angelofraietta/HappyBracketsPiHats/Image1.jpg

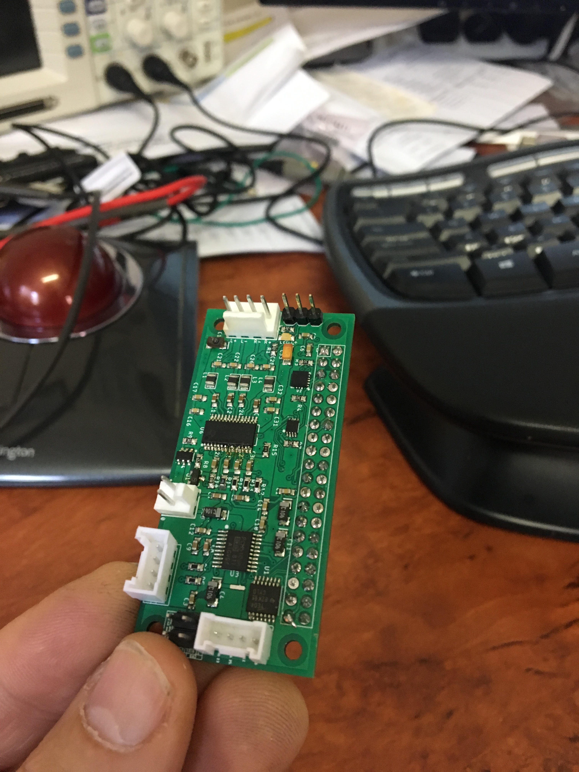
Image1.jpg
