angelofraietta/HappyBracketsPiHats/j8header-zero.png

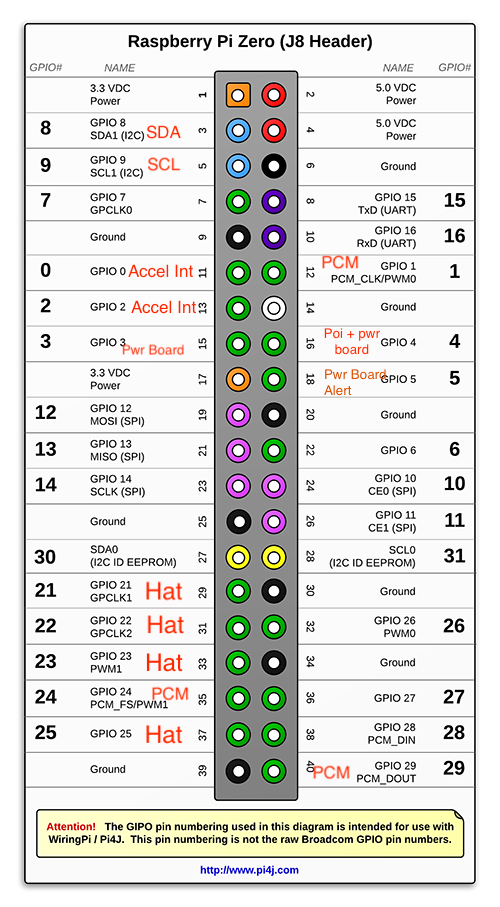
j8header-zero.png
