angelofraietta/HappyBracketsPiHats/PiZeroAudioI2S-01-Nov-18.xlsx

Part | list exported |  | from /Users/angelofraiet | ta/Documents/EAGLE/projects/HappyBracketsPiHats/ | PiZeroAudioI2S
Qty | Value | MPN | Device | Package | Parts | Description
9 | 0.1uF | CL10F104ZB8NNNC | C-EUC0603 | C0603 | C1, C2, C3, C6, C10, C12, C14, C17, C34 | CAPACITOR, European symbol
2 | 100uF | TLJA107M010R1400 | CAP-POLARISED1206-POLAR | EIA3216 | C18, C35 | Polarised capacitor 0603 Footprint
4 | 10K | RC0603FR-0710KL | R-US_R0603 | R0603 | R3, R4, R7, R14 | RESISTOR, American symbol
1 | 10R | RNCP0603FTD10R0 | R-US_R0603 | R0603 | R13 | RESISTOR, American symbol
4 | 10uF | F931C106MAA | CAP-POLARISED1206-POLAR | EIA3216 | C4, C11, C13, C15 | Polarised capacitor 0603 Footprint
6 | 1nF | 06035C102KAT2A | C-EUC0603 | C0603 | C16, C22, C23, C27, C29, C33 | CAPACITOR, European symbol
6 | 1uF | CL10B105MO8NNWC | C-EUC0603 | C0603 | C19, C21, C26, C28, C30, C32 | CAPACITOR, European symbol
2 | 2.2nF | 0603B222K500CT | C-EUC0603 | C0603 | C5, C7 | CAPACITOR, European symbol
2 | 2.2uF | C0603C225K8PACTU | C-EUC0603 | C0603 | C8, C9 | CAPACITOR, European symbol
2 | 220 | RC0603FR-07220RL | R-US_R0603 | R0603 | R1, R2 | RESISTOR, American symbol
4 | 220nF | EMK107B7224KA-T | C-EUC0603 | C0603 | C20, C24, C25, C31 | CAPACITOR, European symbol
1 | 2X1-LOCKING | 22-23-2021 | 2X1-LOCKING | 22-23-2021 | J3 | 2x1 Locking Header
1 | 2X2HEADER | PRPC002DAAN-RC | 2X2HEADER | 2X2 | J2 | 2x2 2.54mm header
3 | 33K | MCMR06X3302FTL | R-US_R0603 | R0603 | R10, R11, R12 | RESISTOR, American symbol
1 | 39K | RC0603FR-0739KL | R-US_R0603 | R0603 | R8 | RESISTOR, American symbol
2 | 76K8 | RMCF0603FT76K8 | R-US_R0603 | R0603 | R5, R6 | RESISTOR, American symbol
1 | 4X1-LOCKING | 22-23-2041 | 4X1-LOCKING | 22-23-2041 | J5
1 | 56K | CRCW060356K0FKEA. | R-US_R0603 | R0603 | R9 | RESISTOR, American symbol
1 | DMG2305UX | DMG2305UX-7 | DMG2305UX | SOT23 | Q1 | P-CHANNEL ENHANCEMENT MODE MOSFET
4 | FB | NFZ2MSM301SN10L | NFZ2MSML0806 | L0806 | L1, L2, L3, L4 | Ferrite Bead
2 | GROVE | 110990030 | GROVE | JST-PH4 | J1, J4
1 | Header 1x3 | PRPC003SAAN-RC | PINHD-1X3 | 1X03 | JP1 | PIN HEADER
1 | LSM6DS33 | LSM6DS33TR | LSM6DS33LGA-16-3X3 | LGA-16-3X3 | U2 | iNEMO inertial module:
1 | PCM5101A | PCM5101AQPWRQ1 | PCM5101A | TSSOP20-0.65-6.5X4.4MM | U3 | PCM510xA 2.1VRMS, 112/106/100dB AudioStereoDAC with PLL and 32-bit, 384 kHz PCM Interface
1 | RED | LH R974-LP-1 | LEDCHIP-LED0805 | CHIP-LED0805 | LED1 | LED
1 | RPI-Header | ADA2243 | 20x2 Header | Mounted on Bottom of board | CON1 | Mounted on Bottom Of Board
1 | TPA3144D2PWPR | TPA3144D2PWPR | TPA3144D2PWPR | HTSSOP28 | U5 | TPA3144D2PWPR
1 | TXB0104PWR | TXB0104PWR | TXB0104PWR | TSSOP14 | U1 | 4-Bit Bi-Directional Level Shifter
1 | TXS0102 | TXS0102DCURG4 | TXS0102 | VFSOP-8 | U4 | 2-Bit Bi-Directional Level Shifter (I2C, etc.)
