angelofraietta/HappyBracketsPiHats/Pi Zero I2S Bill of Materials.pdf

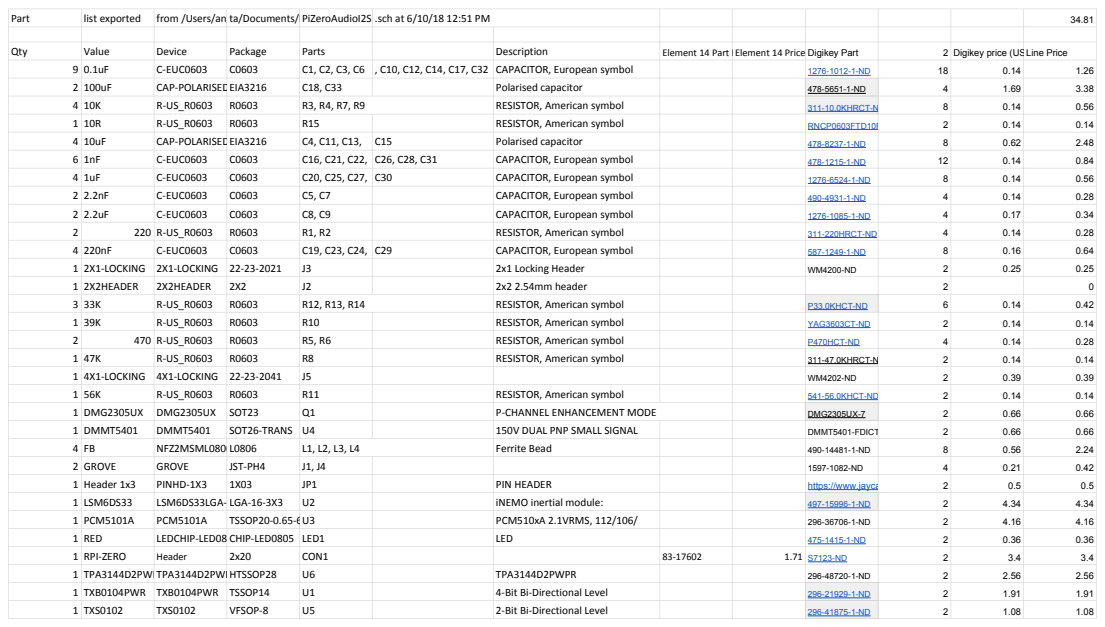
[picture p3: page 1]
