angelofraietta/HappyBracketsPiHats/PiZeroAudioI2S.pdf

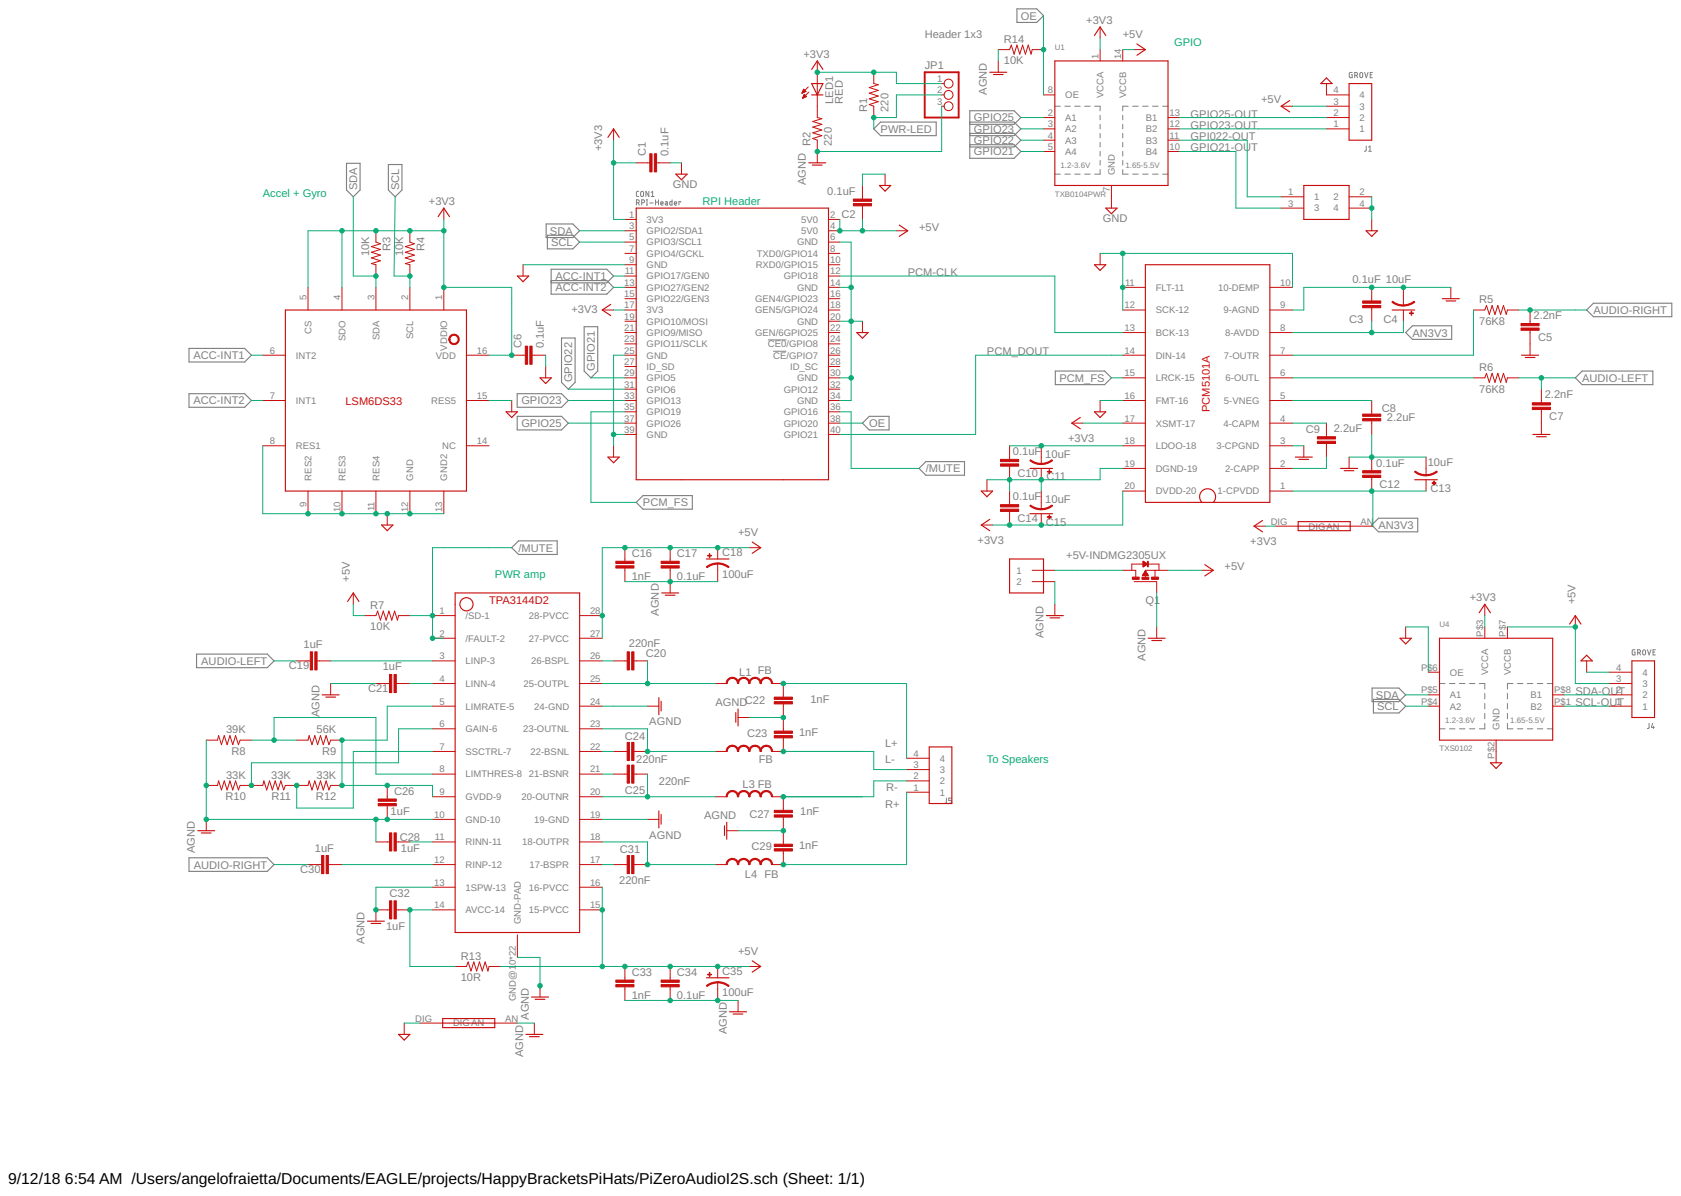
[picture p4: page 1]

9/12/18 6:54 AM /Users/angelofraietta/Documents/EAGLE/projects/HappyBracketsPiHats/PiZeroAudioI2S.sch (Sheet: 1/1)
