angelofraietta/HappyBracketsPiHats/PiZeroHifi.brd

## EAGLE design PiZeroHifi.brd (2020-08-05)

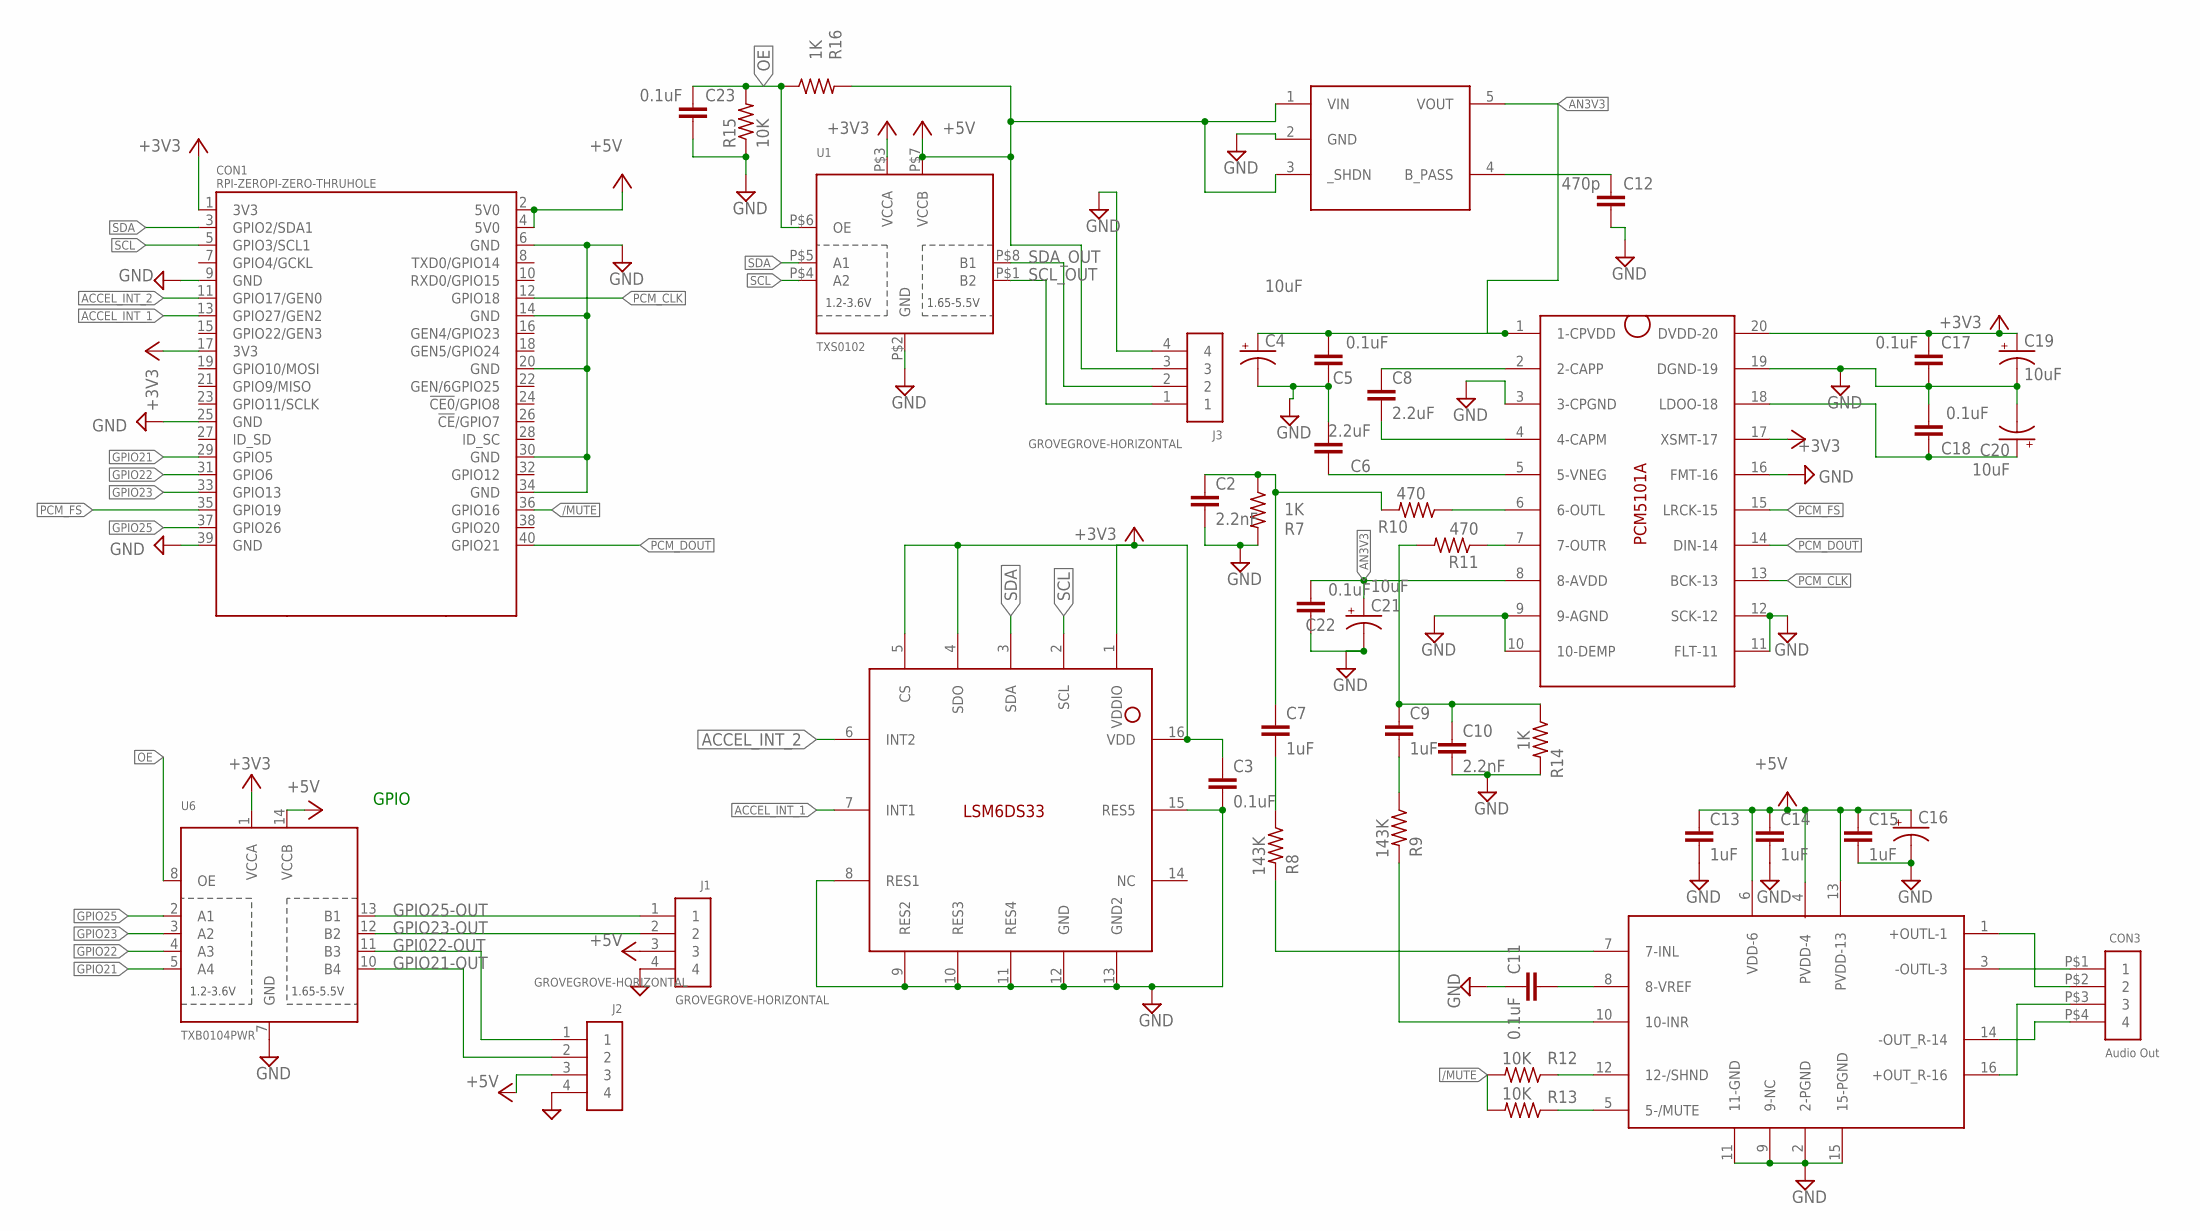
[picture p5: schematic PiZeroHifi.sch]

Parts:
C2, C10: 2.2nF; C0603; MPN CC0603KRX7R9BB222
C3, C5, C11, C17, C18, C22, C23: 0.1uF; C0603; MPN CC0603KRX7R7BB104
C4, C19, C20, C21: 10uF; EIA3216; MPN 08053D106KAT2A
C6, C8: 2.2uF; C0603
C7, C9, C13, C14, C15: 1uF; C0603; MPN 06033C104JAT2A
C12: 470p; C0603; MPN 06035C471KAT2A
C16: 1500uF; CAP8MMX3.5MMX20MM
CON1: RPI-ZEROPI-ZERO-THRUHOLE; RASPBERRYPI_ZERO_THRUHOLE
CON3: Audio Out; TERM-4P-SIDE-5.08MM
J1, J2, J3: GROVEGROVE-HORIZONTAL; JST-4-PTH
R7, R14, R16: 1K; R0603; MPN MCWR06X1001FTL
R8, R9: 143K; R0603; MPN ERJ3EKF1433V
R10, R11: 470; R0603; MPN CRCW0603470RFKEA
R12, R13, R15: 10K; R0603; MPN RC0603FR-0710KL
U1: TXS0102; VFSOP-8
U2: LSM6DS33; LGA-16-3X3
U3: TC1014-3.3V; GHI-IC_SOT23-5(MICROCHIP); MPN TC1014-3.3VCT713
U4: PCM5101A; TSSOP20-0.65-6.5X4.4MM
U5: PAM8403; SOP-16
U6: TXB0104PWR; TSSOP14; MPN TXB0104PWR .

Connections:
+3V3: C3.1, C17.2, C19.+, CON1.1 (3V3), CON1.17 (3V3), U1.P$3 (VCCA), U2.1 (VDDIO), U2.4 (SDO), U2.5 (CS), U2.16 (VDD), U4.17 (XSMT-17), U4.20 (DVDD-20), U6.1 (VCCA)
+5V: C13.1, C14.1, C15.1, C16.P$1 (+), CON1.2 (5V0), CON1.4 (5V0), J1.3, J2.3, J3.3, R16.2, U1.P$7 (VCCB), U3.1 (VIN), U3.3 (_SHDN), U5.4 (PVDD-4), U5.6 (VDD-6), U5.13 (PVDD-13), U6.14 (VCCB)
+L: CON3.P$2 (2), U5.1 (+OUTL-1)
+R: CON3.P$3 (3), U5.16 (+OUT_R-16)
-L: CON3.P$1 (1), U5.3 (-OUTL-3)
-R: CON3.P$4 (4), U5.14 (-OUT_R-14)
/MUTE: CON1.36 (GPIO16), R12.2, R13.2
ACCEL_INT_1: CON1.13 (GPIO27/GEN2), U2.7 (INT1)
ACCEL_INT_2: CON1.11 (GPIO17/GEN0), U2.6 (INT2)
AN3V3: C4.+, C5.2, C21.+, C22.2, U3.5 (VOUT), U4.1 (1-CPVDD), U4.8 (8-AVDD)
GND: C2.2, C3.2, C4.-, C5.1, C6.2, C10.2, C11.2, C12.1, C13.2, C14.2, C15.2, C16.P$2 (-), C17.1, C18.2, C19.-, C20.-, C21.-, C22.1, C23.1, CON1.6 (GND), CON1.9 (GND), CON1.14 (GND), CON1.20 (GND), CON1.25 (GND), CON1.30 (GND), CON1.34 (GND), CON1.39 (GND), J1.4, J2.4, J3.4, R7.2, R14.2, R15.1, U1.P$2 (GND), U2.8 (RES1), U2.9 (RES2), U2.10 (RES3), U2.11 (RES4), U2.12 (GND), U2.13 (GND2), U2.15 (RES5), U3.2 (GND), U4.3 (3-CPGND), U4.9 (9-AGND), U4.10 (10-DEMP), U4.11 (FLT-11), U4.12 (SCK-12), U4.16 (FMT-16), U4.19 (DGND-19), U5.2 (2-PGND), U5.9 (9-NC), U5.11 (11-GND), U5.15 (15-PGND), U6.7 (GND)
GPI022-OUT: J2.1, U6.11 (B3)
GPIO21: CON1.29 (GPIO5), U6.5 (A4)
GPIO21-OUT: J2.2, U6.10 (B4)
GPIO22: CON1.31 (GPIO6), U6.4 (A3)
GPIO23: CON1.33 (GPIO13), U6.3 (A2)
GPIO23-OUT: J1.2, U6.12 (B2)
GPIO25: CON1.37 (GPIO26), U6.2 (A1)
GPIO25-OUT: J1.1, U6.13 (B1)
unnamed: C8.1, U4.2 (2-CAPP)
unnamed: C8.2, U4.4 (4-CAPM)
unnamed: C6.1, U4.5 (5-VNEG)
unnamed: C18.1, C20.+, U4.18 (LDOO-18)
unnamed: R10.1, U4.6 (6-OUTL)
unnamed: R11.1, U4.7 (7-OUTR)
unnamed: C7.2, R8.1
unnamed: C9.1, C10.1, R11.2, R14.1
unnamed: C2.1, C7.1, R7.1, R10.2
unnamed: C9.2, R9.1
unnamed: R8.2, U5.7 (7-INL)
unnamed: R9.2, U5.10 (10-INR)
unnamed: C12.2, U3.4 (B_PASS)
unnamed: C11.1, U5.8 (8-VREF)
unnamed: R12.1, U5.12 (12-/SHND)
unnamed: R13.1, U5.5 (5-/MUTE)
OE: C23.2, R15.2, R16.1, U1.P$6 (OE), U6.8 (OE)
PCM_CLK: CON1.12 (GPIO18), U4.13 (BCK-13)
PCM_DOUT: CON1.40 (GPIO21), U4.14 (DIN-14)
PCM_FS: CON1.35 (GPIO19), U4.15 (LRCK-15)
SCL: CON1.5 (GPIO3/SCL1), U1.P$4 (A2), U2.2 (SCL)
SCL_OUT: J3.1, U1.P$1 (B2)
SDA: CON1.3 (GPIO2/SDA1), U1.P$5 (A1), U2.3 (SDA)
SDA_OUT: J3.2, U1.P$8 (B1)

Notes on the sheet:
GPIO

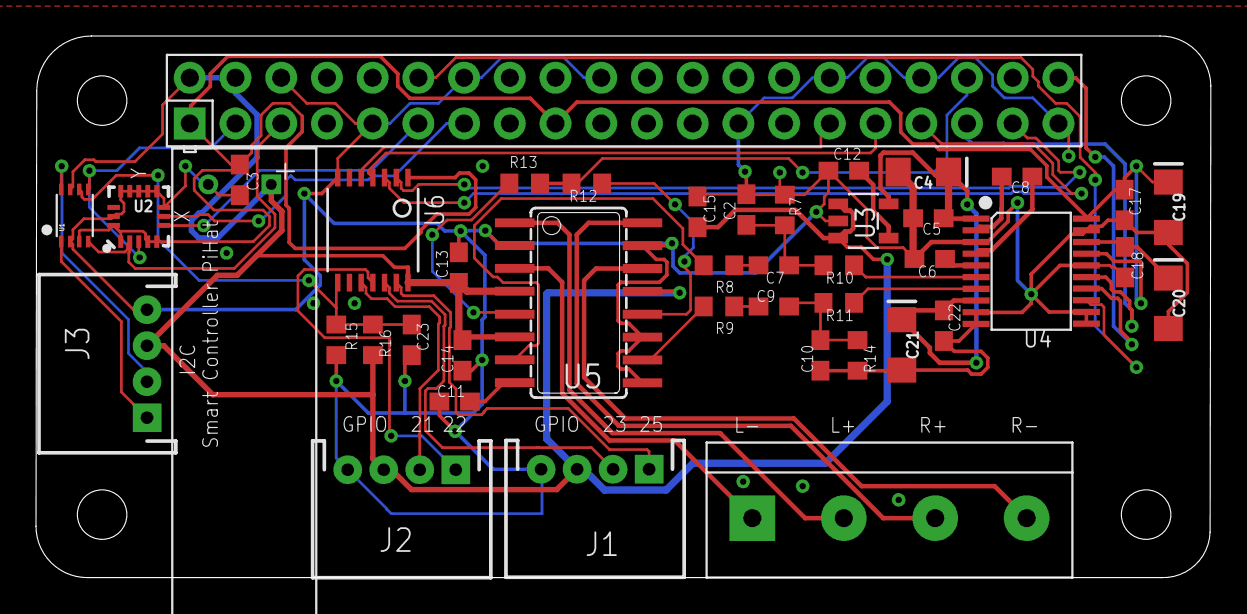
[picture p6: board PiZeroHifi.brd from above]

Board: 2 copper layers, 65.3 x 30.1 mm, 43 parts (0 on the bottom side), 43 nets.
