angelofraietta/HappyBracketsPiHats/PiZeroAudio.brd

## EAGLE design PiZeroAudio.brd (2020-05-15)

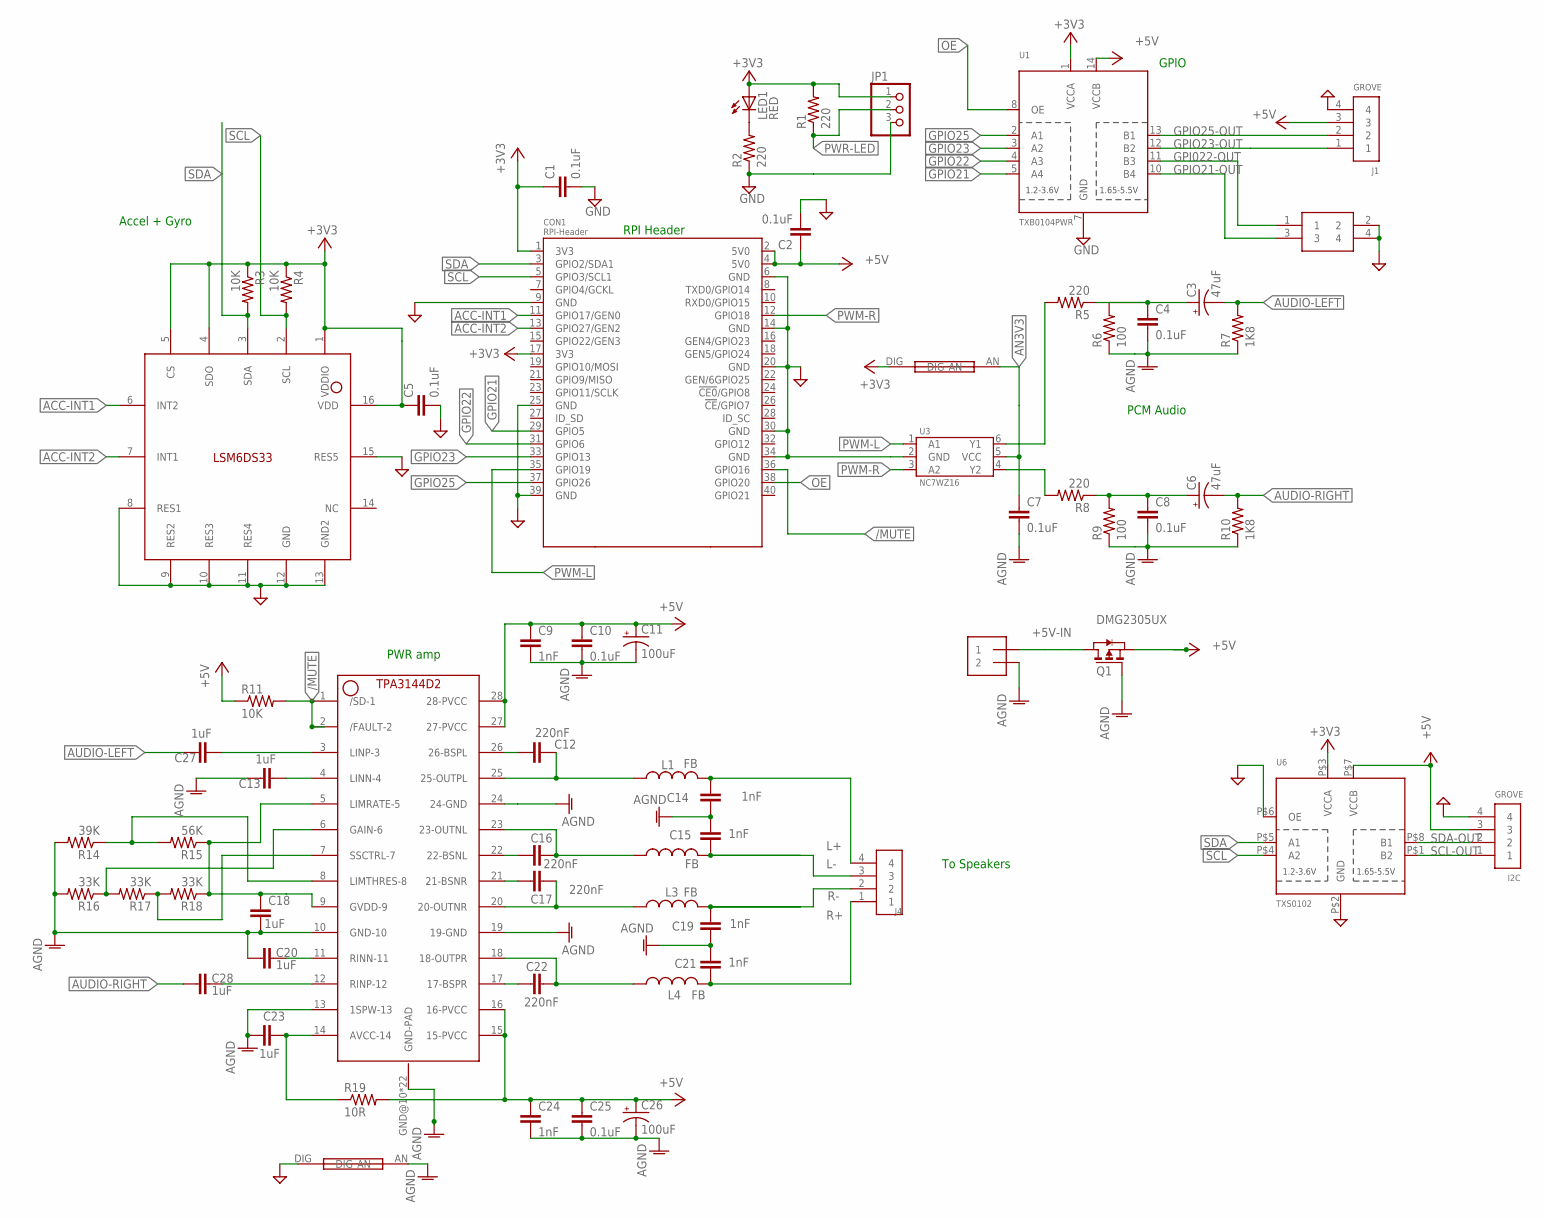
[picture p7: schematic PiZeroAudio.sch]

Parts:
C1, C2, C4, C5, C7, C8, C10, C25: 0.1uF; C0603
C3, C6: 47uF; EIA3216
C9, C14, C15, C19, C21, C24: 1nF; C0603
C11, C26: 100uF; EIA3216
C12, C16, C17, C22: 220nF; C0603
C13, C18, C20, C23, C27, C28: 1uF; C0603
CON1: RPI-Header; RASPBERRYPI_BASTELSTUBE_V13_RASPI_BOARD_B+_FULL
I2C: GROVE; JST-PH4
J1: GROVE; JST-PH4
J2: 2X2HEADER; 2X2
J3: 2X1-LOCKING; 22-23-2021
J4: 4X1-LOCKING; 22-23-2041
JP1: Header 1x3; 1X03
L1, L2, L3, L4: FB; L0806
LED1: RED; CHIP-LED0805
Q1: DMG2305UX; SOT23
R1, R2, R5, R8: 220; R0603
R3, R4, R11: 10K; R0603
R6, R9: 100; R0603
R7, R10: 1K8; R0603
R14: 39K; R0603
R15: 56K; R0603
R16, R17, R18: 33K; R0603
R19: 10R; R0603
SH1, SH2: SHORT
U1: TXB0104PWR; TSSOP14
U2: LSM6DS33; LGA-16-3X3
U3: NC7WZ16; SC-70-6
U5: TPA3144D2PWPR; HTSSOP28
U6: TXS0102; VFSOP-8

Connections:
+3V3: C1.1, C5.1, CON1.1 (3V3), CON1.17 (3V3), JP1.1, LED1.A, R1.2, R3.1, R4.1, SH1.DIG, U1.1 (VCCA), U2.1 (VDDIO), U2.4 (SDO), U2.5 (CS), U2.16 (VDD), U6.P$3 (VCCA)
+5V: C2.1, C9.1, C10.1, C11.+, C24.1, C25.1, C26.+, CON1.2 (5V0), CON1.4 (5V0), I2C.3, J1.3, Q1.S, R11.1, R19.2, U1.14 (VCCB), U5.15 (15-PVCC), U5.16 (16-PVCC), U5.27 (27-PVCC), U5.28 (28-PVCC), U6.P$7 (VCCB)
+5V-IN: J3.1, Q1.D
/MUTE: CON1.36 (GPIO16), R11.2, U5.1 (/SD-1), U5.2 (/FAULT-2)
ACC-INT1: CON1.11 (GPIO17/GEN0), U2.6 (INT2)
ACC-INT2: CON1.13 (GPIO27/GEN2), U2.7 (INT1)
AGND: C4.2, C7.2, C8.2, C9.2, C10.2, C11.-, C13.2, C14.2, C15.1, C18.2, C19.2, C20.2, C21.1, C23.2, C24.2, C25.2, C26.-, J3.2, Q1.G, R6.1, R7.1, R9.1, R10.1, R14.2, R16.2, SH2.AN, U5.10 (GND-10), U5.13 (1SPW-13), U5.19 (19-GND), U5.24 (24-GND), U5.GND@10 (GND-PAD), U5.GND@11 (GND-PAD), U5.GND@12 (GND-PAD), U5.GND@13 (GND-PAD), U5.GND@14 (GND-PAD), U5.GND@15 (GND-PAD), U5.GND@16 (GND-PAD), U5.GND@17 (GND-PAD), U5.GND@18 (GND-PAD), U5.GND@19 (GND-PAD), U5.GND@20 (GND-PAD), U5.GND@21 (GND-PAD), U5.GND@22 (GND-PAD), U5.GND@23 (GND-PAD), U5.GND@24 (GND-PAD), U5.GND@25 (GND-PAD), U5.GND@26 (GND-PAD), U5.GND@27 (GND-PAD), U5.GND@28 (GND-PAD), U5.GND@29 (GND-PAD), U5.GND@30 (GND-PAD), U5.GND@PAD (GND-PAD)
AN3V3: C7.1, SH1.AN, U3.5 (VCC)
AUDIO-LEFT: C3.-, C27.2, R7.2
AUDIO-RIGHT: C6.-, C28.2, R10.2
GND: C1.2, C2.2, C5.2, CON1.6 (GND), CON1.9 (GND), CON1.14 (GND), CON1.20 (GND), CON1.25 (GND), CON1.30 (GND), CON1.34 (GND), CON1.39 (GND), I2C.4, J1.4, J2.2, J2.4, JP1.3, R2.1, SH2.DIG, U1.7 (GND), U2.8 (RES1), U2.9 (RES2), U2.10 (RES3), U2.11 (RES4), U2.12 (GND), U2.13 (GND2), U2.15 (RES5), U3.2 (GND), U6.P$2 (GND), U6.P$6 (OE)
GPI022-OUT: J2.1, U1.11 (B3)
GPIO21: CON1.29 (GPIO5), U1.5 (A4)
GPIO21-OUT: J2.3, U1.10 (B4)
GPIO22: CON1.31 (GPIO6), U1.4 (A3)
GPIO23: CON1.33 (GPIO13), U1.3 (A2)
GPIO23-OUT: J1.1, U1.12 (B2)
GPIO25: CON1.37 (GPIO26), U1.2 (A1)
GPIO25-OUT: J1.2, U1.13 (B1)
L+: C14.1, J4.4, L1.2
L-: C15.2, J4.3, L2.2
unnamed: C3.+, C4.1, R5.1, R6.2
unnamed: R5.2, U3.6 (Y1)
unnamed: R8.2, U3.4 (Y2)
unnamed: C6.+, C8.1, R8.1, R9.2
unnamed: C27.1, U5.3 (LINP-3)
unnamed: LED1.C, R2.2
unnamed: C13.1, U5.4 (LINN-4)
unnamed: C20.1, U5.11 (RINN-11)
unnamed: C23.1, R19.1, U5.14 (AVCC-14)
unnamed: C22.2, U5.17 (17-BSPR)
unnamed: C28.1, U5.12 (RINP-12)
unnamed: C17.2, U5.21 (21-BSNR)
unnamed: C16.2, U5.22 (22-BSNL)
unnamed: C12.2, U5.26 (26-BSPL)
unnamed: C12.1, L1.1, U5.25 (25-OUTPL)
unnamed: C16.1, L2.1, U5.23 (23-OUTNL)
unnamed: C17.1, L3.1, U5.20 (20-OUTNR)
unnamed: C22.1, L4.1, U5.18 (18-OUTPR)
unnamed: R16.1, R17.2, U5.6 (GAIN-6)
unnamed: R17.1, R18.2, U5.7 (SSCTRL-7)
unnamed: R14.1, R15.2, U5.8 (LIMTHRES-8)
unnamed: C18.1, R15.1, R18.1, U5.5 (LIMRATE-5), U5.9 (GVDD-9)
OE: CON1.38 (GPIO20), U1.8 (OE)
PWM-L: CON1.35 (GPIO19), U3.1 (A1)
PWM-R: CON1.12 (GPIO18), U3.3 (A2)
PWR-LED: JP1.2, R1.1
R+: C21.2, J4.1, L4.2
R-: C19.1, J4.2, L3.2
SCL: CON1.5 (GPIO3/SCL1), R4.2, U2.2 (SCL), U6.P$4 (A2)
SCL-OUT: I2C.1, U6.P$1 (B2)
SDA: CON1.3 (GPIO2/SDA1), R3.2, U2.3 (SDA), U6.P$5 (A1)
SDA-OUT: I2C.2, U6.P$8 (B1)

Notes on the sheet:
Accel + Gyro
GPIO
PCM Audio
PWR amp
RPI Header
To Speakers

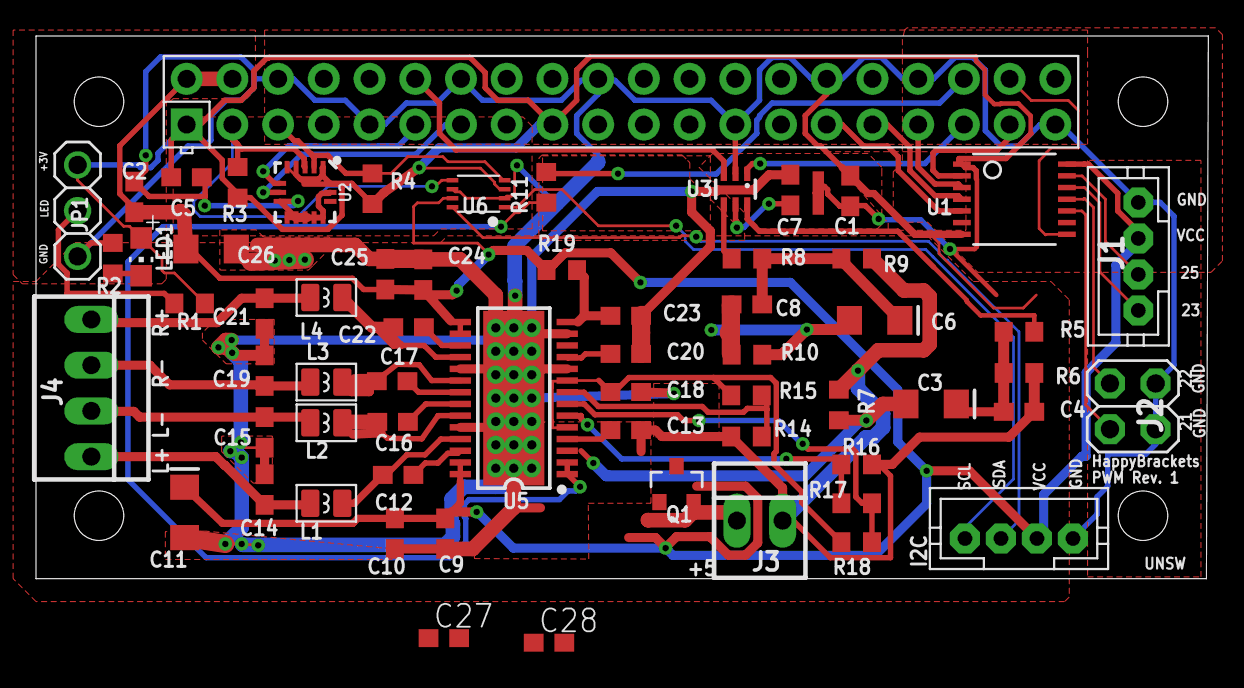
[picture p8: board PiZeroAudio.brd from above]

Board: 2 copper layers, 65.1 x 30.2 mm, 65 parts (0 on the bottom side), 53 nets.
