angelofraietta/HappyBracketsPiHats/PiZeroAudioI2SPam8403.brd

## EAGLE design PiZeroAudioI2SPam8403.brd (2020-05-15)

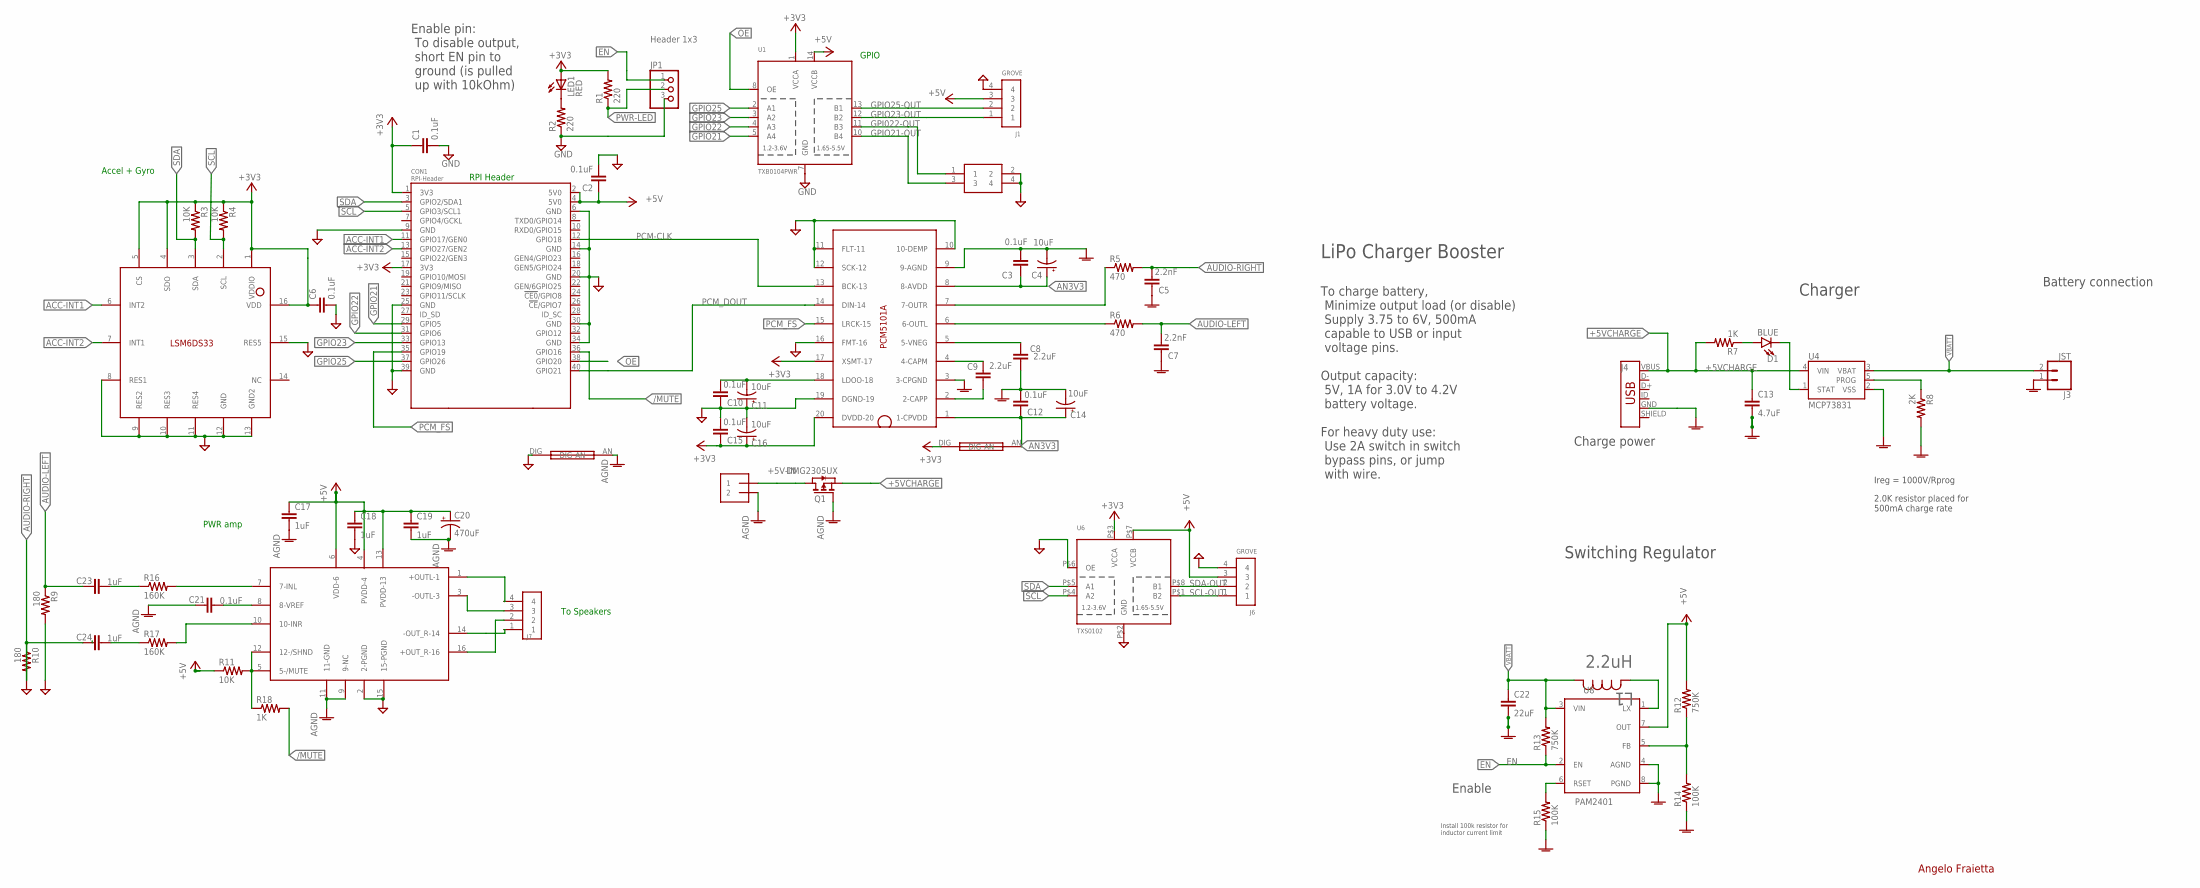
[picture p9: schematic PiZeroAudioI2SPam8403.sch]

Parts:
C1, C2, C3, C6, C10, C12, C15, C21: 0.1uF; C0603; MPN MC0603F104Z500CT
C4, C11, C14, C16: 10uF; EIA3216; MPN F931C106MAA
C5, C7: 2.2nF; C0603
C8, C9: 2.2uF; C0603; MPN TMK107ABJ225KA-T
C13: 4.7uF; C0603
C17, C18, C19: 1uF; C0603
C20: 470uF; EIA7343; MPN 293D477X9010E2TE3
C22: 22uF; C0603; MPN GRM188R61A226ME15D
C23, C24: 1uF; C0603; MPN MC0603F104Z500CT
CON1: RPI-Header; RASPBERRYPI_BASTELSTUBE_V13_RASPI_BOARD_B+_FULL
D1: BLUE; LED-0603
J1, J6: GROVE; JST-PH4
J2: 2X2HEADER; 2X2
J3: JST; JST-2-SMD; MPN S2B-PH-SM4-TB(LF)(SN)
J4: AMP FCI 10103594-0001LF; USB-MICROB-PTH; MPN 10103594-0001LF
J5: 2X1-LOCKING; 22-23-2021
J7: 4X1-LOCKING; 22-23-2041
JP1: Header 1x3; 1X03
L1: 2.2uH; IND_IFSC_1515AH; MPN IFSC1515AHER2R2M01
LED1: RED; CHIP-LED0805
Q1: DMG2305UX; SOT23; MPN DMG2305UX-7
R1, R2: 220; R0603; MPN RC0603FR-07220RL
R3, R4, R11: 10K; R0603; MPN RC0603FR-0710KL
R5, R6: 470; R0603; MPN ERJ3EKF4700V
R7: 1K; R0603; MPN CRCW06031K00FKEA
R8: 2K; R0603
R9, R10: 180; R0603; MPN ERJ3EKF4700V
R12, R13: 750K; R0603; MPN CRCW0603750KFKEA
R14, R15: 100K; R0603; MPN ERJ-3EKF1003V
R16, R17: 160K; R0603; MPN ERJ3EKF4700V
R18: 1K; R0603; MPN RC0603FR-0710KL
SH1, SH2: SHORT
U1: TXB0104PWR; TSSOP14; MPN TXB0104PWR
U2: LSM6DS33; LGA-16-3X3; MPN LSM6DS33TR
U3: PCM5101A; TSSOP20-0.65-6.5X4.4MM; MPN PCM5101AQPWRQ1
U4: MCP73831; SOT23-5; MPN MCP73831T-2ACI/OT
U6: TXS0102; VFSOP-8
U7: PAM8403; SOP-16
U8: PAM2401; MSOP8

Connections:
+3V3: C1.1, C6.1, C15.2, C16.+, CON1.1 (3V3), CON1.17 (3V3), LED1.A, R1.2, R3.1, R4.1, SH1.DIG, U1.1 (VCCA), U2.1 (VDDIO), U2.4 (SDO), U2.5 (CS), U2.16 (VDD), U3.17 (XSMT-17), U3.20 (DVDD-20), U6.P$3 (VCCA)
+5V: C2.1, C17.1, C18.1, C19.1, C20.+, CON1.2 (5V0), CON1.4 (5V0), J1.3, J6.3, R11.1, R12.2, U1.14 (VCCB), U6.P$7 (VCCB), U7.4 (PVDD-4), U7.6 (VDD-6), U7.13 (PVDD-13), U8.7 (OUT)
+5V-IN: J5.1, Q1.D
+5VCHARGE: C13.1, J4.VBUS, Q1.S, R7.2, U4.4 (VIN)
/MUTE: CON1.36 (GPIO16), R11.2, R18.1, R18.2, U7.5 (5-/MUTE), U7.12 (12-/SHND)
ACC-INT1: CON1.11 (GPIO17/GEN0), U2.6 (INT2)
ACC-INT2: CON1.13 (GPIO27/GEN2), U2.7 (INT1)
AGND: C3.1, C4.-, C5.2, C7.2, C8.2, C12.1, C13.2, C14.-, C17.2, C19.2, C20.-, C21.2, C22.2, J3.1 (2), J4.GND, J5.2, Q1.G, R8.2, R14.1, R15.1, SH2.AN, U3.3 (3-CPGND), U3.9 (9-AGND), U4.2 (VSS), U7.9 (9-NC), U7.11 (11-GND), U8.4 (AGND), U8.8 (PGND)
AN3V3: C3.2, C4.+, C12.2, C14.+, SH1.AN, U3.1 (1-CPVDD), U3.8 (8-AVDD)
AUDIO-LEFT: C7.1, C23.2, R6.2, R9.1
AUDIO-RIGHT: C5.1, R5.2, R10.1
EN: JP1.1, R13.1, U8.2 (EN)
GND: C1.2, C2.2, C6.2, C10.2, C11.+, C15.1, C16.-, C18.2, C24.2, CON1.6 (GND), CON1.9 (GND), CON1.14 (GND), CON1.20 (GND), CON1.25 (GND), CON1.30 (GND), CON1.34 (GND), CON1.39 (GND), J1.4, J2.2, J2.4, J6.4, JP1.3, R2.1, R9.2, R10.2, SH2.DIG, U1.7 (GND), U2.8 (RES1), U2.9 (RES2), U2.10 (RES3), U2.11 (RES4), U2.12 (GND), U2.13 (GND2), U2.15 (RES5), U3.10 (10-DEMP), U3.11 (FLT-11), U3.12 (SCK-12), U3.16 (FMT-16), U3.19 (DGND-19), U6.P$2 (GND), U6.P$6 (OE), U7.2 (2-PGND), U7.15 (15-PGND)
GPI022-OUT: J2.1, U1.11 (B3)
GPIO21: CON1.29 (GPIO5), U1.5 (A4)
GPIO21-OUT: J2.3, U1.10 (B4)
GPIO22: CON1.31 (GPIO6), U1.4 (A3)
GPIO23: CON1.33 (GPIO13), U1.3 (A2)
GPIO23-OUT: J1.1, U1.12 (B2)
GPIO25: CON1.37 (GPIO26), U1.2 (A1)
GPIO25-OUT: J1.2, U1.13 (B1)
L+: J7.4, U7.1 (+OUTL-1)
L-: J7.3, U7.3 (-OUTL-3)
unnamed: R5.1, U3.7 (7-OUTR)
unnamed: C8.1, U3.5 (5-VNEG)
unnamed: C9.1, U3.4 (4-CAPM)
unnamed: C9.2, U3.2 (2-CAPP)
unnamed: C24.1, R17.1
unnamed: LED1.C, R2.2
unnamed: C21.1, U7.8 (8-VREF)
unnamed: R16.2, U7.7 (7-INL)
unnamed: R17.2, U7.10 (10-INR)
unnamed: R6.1, U3.6 (6-OUTL)
unnamed: C10.1, C11.-, U3.18 (LDOO-18)
unnamed: C23.1, R16.1
unnamed: R8.1, U4.5 (PROG)
unnamed: D1.C, U4.1 (STAT)
unnamed: R12.1, R14.2, U8.5 (FB)
unnamed: L1.2, U8.1 (LX)
unnamed: R15.2, U8.6 (RSET)
unnamed: D1.A, R7.1
OE: CON1.38 (GPIO20), U1.8 (OE)
PCM-CLK: CON1.12 (GPIO18), U3.13 (BCK-13)
PCM_DOUT: CON1.40 (GPIO21), U3.14 (DIN-14)
PCM_FS: CON1.35 (GPIO19), U3.15 (LRCK-15)
PWR-LED: JP1.2, R1.1
R+: J7.2, U7.16 (+OUT_R-16)
R-: J7.1, U7.14 (-OUT_R-14)
SCL: CON1.5 (GPIO3/SCL1), R4.2, U2.2 (SCL), U6.P$4 (A2)
SCL-OUT: J6.1, U6.P$1 (B2)
SDA: CON1.3 (GPIO2/SDA1), R3.2, U2.3 (SDA), U6.P$5 (A1)
SDA-OUT: J6.2, U6.P$8 (B1)
VBATT: C22.1, J3.2 (1), L1.1, R13.2, U4.3 (VBAT), U8.3 (VIN)

Notes on the sheet:
Accel + Gyro
GPIO
PWR amp
RPI Header
To Speakers
Charger
Switching Regulator
Angelo Fraietta
2.0K resistor placed for 500mA charge rate
Ireg = 1000V/Rprog
To charge battery, Minimize output load (or disable) Supply 3.75 to 6V, 500mA capable to USB or input voltage pins.
Install 100k resistor for inductor current limit
LiPo Charger Booster
Output capacity: 5V, 1A for 3.0V to 4.2V battery voltage.
Enable pin: To disable output, short EN pin to ground (is pulled up with 10kOhm)
Enable
Charge power
Battery connection
For heavy duty use: Use 2A switch in switch bypass pins, or jump with wire.

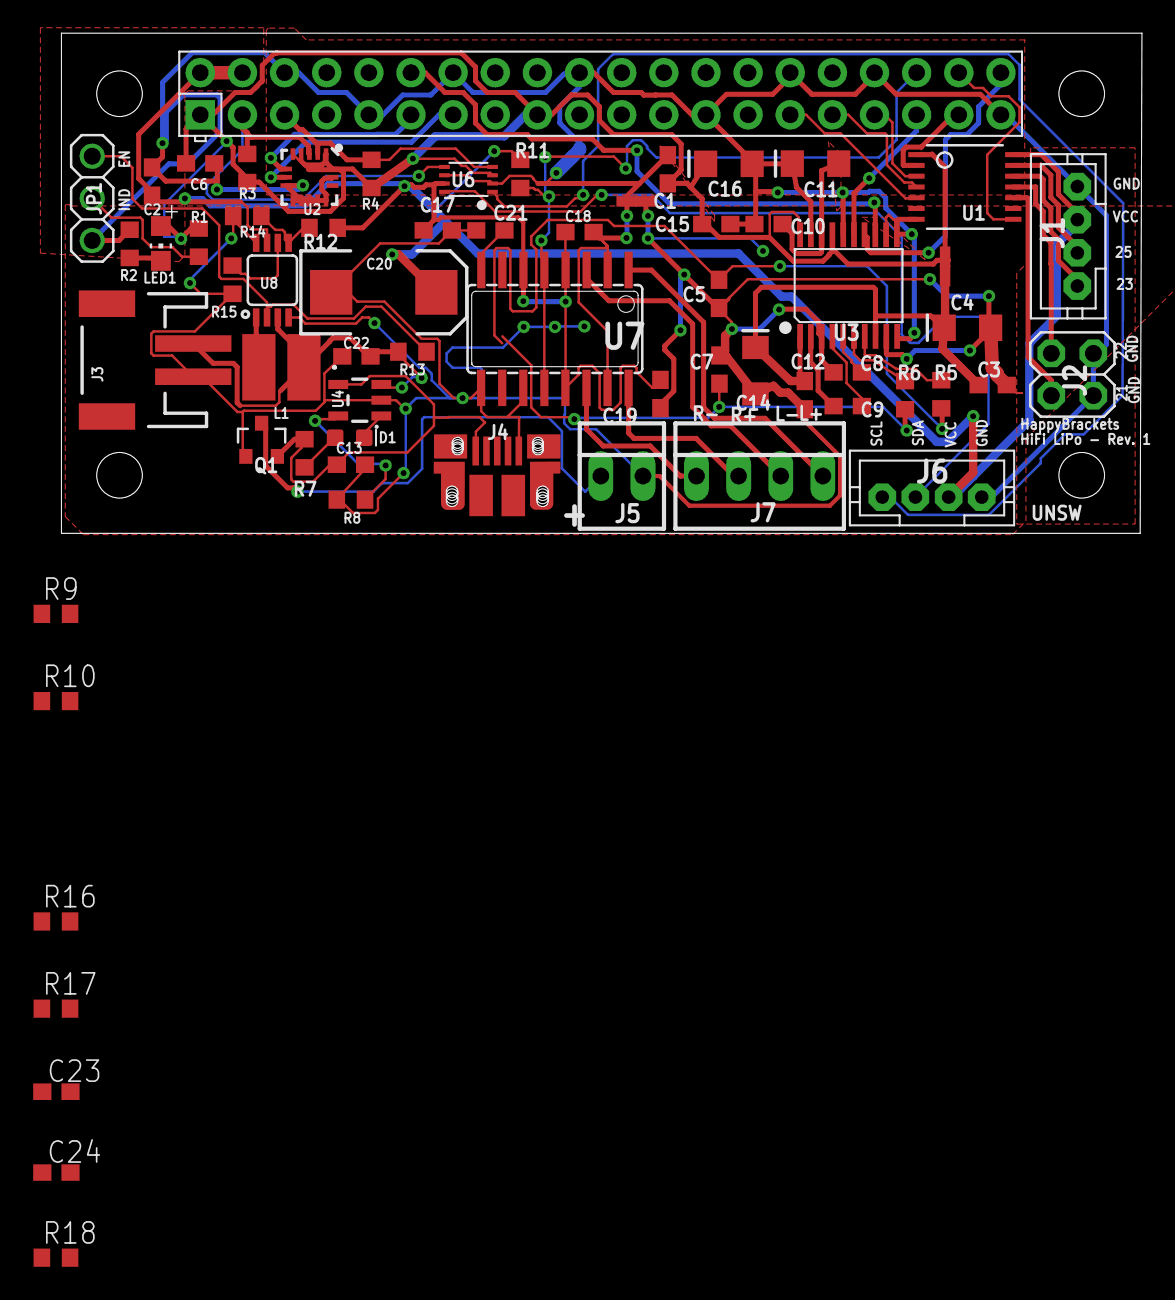
[picture p10: board PiZeroAudioI2SPam8403.brd from above]

Board: 2 copper layers, 65.1 x 30.2 mm, 64 parts (0 on the bottom side), 53 nets.
