angelofraietta/HappyBracketsPiHats/PiZeroAudioI2S.brd

## EAGLE design PiZeroAudioI2S.brd (2020-05-15)

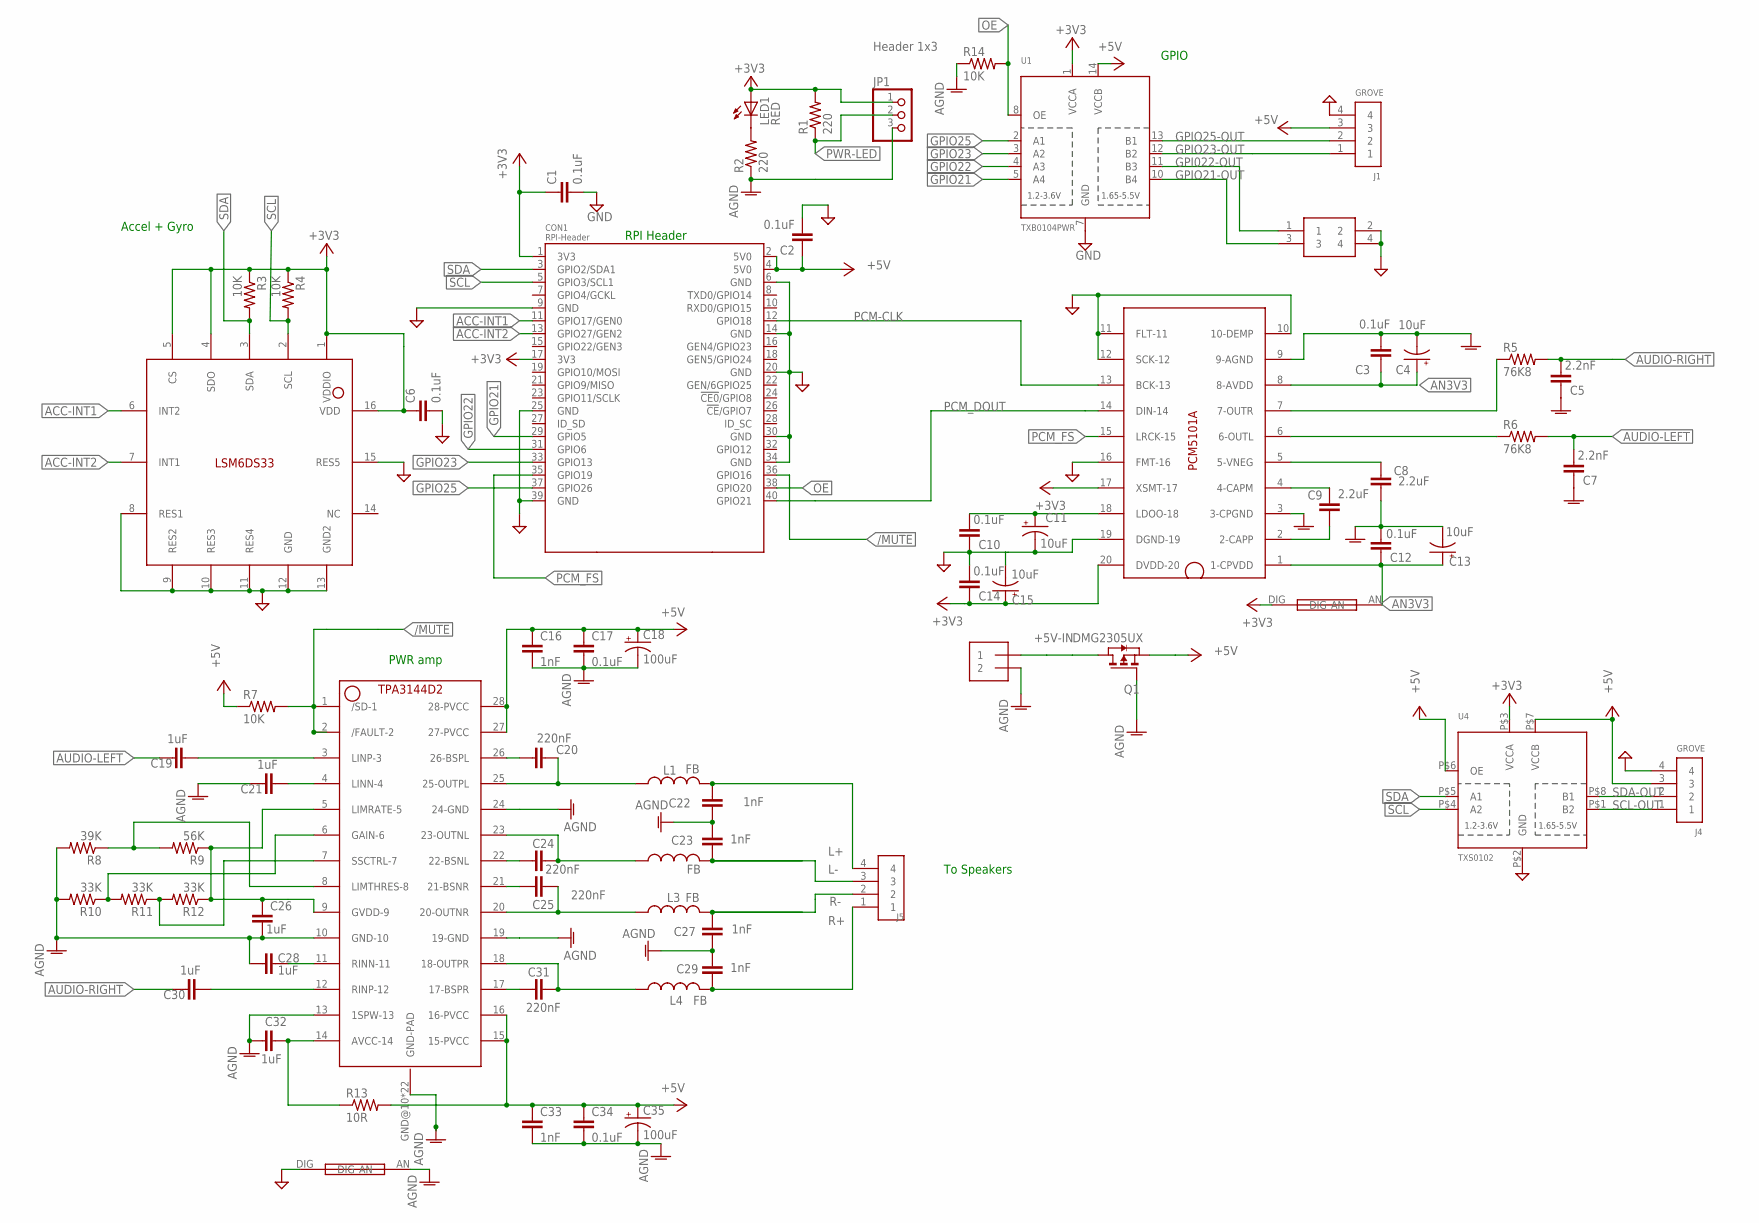
[picture p11: schematic PiZeroAudioI2S.sch]

Parts:
C1, C2, C3, C6, C10, C12, C14, C17, C34: 0.1uF; C0603
C4, C11, C13, C15: 10uF; EIA3216; MPN F931C106MAA
C5, C7: 2.2nF; C0603; MPN 0603B222K500CT
C8, C9: 2.2uF; C0603; MPN C0603C225K8PACTU
C16, C22, C23, C27, C29, C33: 1nF; C0603; MPN 06035C102KAT2A
C18, C35: 100uF; EIA3216; MPN TLJA107M010R1400
C19, C21, C26, C28, C30, C32: 1uF; C0603
C20, C24, C25, C31: 220nF; C0603; MPN EMK107B7224KA-T
CON1: RPI-Header; RASPBERRYPI_BASTELSTUBE_V13_RASPI_BOARD_B+_FULL
J1, J4: GROVE; JST-PH4
J2: 2X2HEADER; 2X2
J3: 2X1-LOCKING; 22-23-2021; MPN 22-23-2021
J5: 4X1-LOCKING; 22-23-2041; MPN 22-23-2041
JP1: Header 1x3; 1X03
L1, L2, L3, L4: FB; L0806
LED1: RED; CHIP-LED0805
Q1: DMG2305UX; SOT23; MPN DMG2305UX-7
R1, R2: 220; R0603
R3, R4, R7, R14: 10K; R0603; MPN RC0603FR-0710KL
R5, R6: 76K8; R0603; MPN RMCF0603FT76K8
R8: 39K; R0603; MPN RC0603FR-0739KL
R9: 56K; R0603; MPN CRCW060356K0FKEA.
R10, R11, R12: 33K; R0603; MPN MCMR06X3302FTL
R13: 10R; R0603
SH1, SH2: SHORT
U1: TXB0104PWR; TSSOP14; MPN TXB0104PWR
U2: LSM6DS33; LGA-16-3X3; MPN LSM6DS33TR
U3: PCM5101A; TSSOP20-0.65-6.5X4.4MM; MPN PCM5101AQPWRQ1
U4: TXS0102; VFSOP-8
U5: TPA3144D2PWPR; HTSSOP28

Connections:
+5V-IN: J3.1, Q1.D
/MUTE: CON1.36 (GPIO16), R7.2, U5.1 (/SD-1), U5.2 (/FAULT-2)
ACC-INT1: CON1.11 (GPIO17/GEN0), U2.6 (INT2)
ACC-INT2: CON1.13 (GPIO27/GEN2), U2.7 (INT1)
AGND: C3.1, C4.-, C5.2, C7.2, C8.2, C12.1, C13.-, C16.2, C17.2, C18.-, C21.2, C22.2, C23.1, C26.2, C27.2, C28.2, C29.1, C32.2, C33.2, C34.2, C35.-, J3.2, JP1.3, Q1.G, R2.1, R8.2, R10.2, R14.1, SH2.AN, U3.3 (3-CPGND), U3.9 (9-AGND), U5.10 (GND-10), U5.13 (1SPW-13), U5.19 (19-GND), U5.24 (24-GND), U5.GND@10 (GND-PAD), U5.GND@11 (GND-PAD), U5.GND@12 (GND-PAD), U5.GND@13 (GND-PAD), U5.GND@14 (GND-PAD), U5.GND@15 (GND-PAD), U5.GND@16 (GND-PAD), U5.GND@17 (GND-PAD), U5.GND@18 (GND-PAD), U5.GND@19 (GND-PAD), U5.GND@20 (GND-PAD), U5.GND@21 (GND-PAD), U5.GND@22 (GND-PAD), U5.GND@23 (GND-PAD), U5.GND@24 (GND-PAD), U5.GND@25 (GND-PAD), U5.GND@26 (GND-PAD), U5.GND@27 (GND-PAD), U5.GND@28 (GND-PAD), U5.GND@29 (GND-PAD), U5.GND@30 (GND-PAD), U5.GND@PAD (GND-PAD)
AN3V3: C3.2, C4.+, C12.2, C13.+, SH1.AN, U3.1 (1-CPVDD), U3.8 (8-AVDD)
AUDIO-LEFT: C7.1, C19.2, R6.2
AUDIO-RIGHT: C5.1, C30.2, R5.2
GND: C1.2, C2.2, C6.2, C10.2, C11.-, C14.1, C15.-, CON1.6 (GND), CON1.9 (GND), CON1.14 (GND), CON1.20 (GND), CON1.25 (GND), CON1.30 (GND), CON1.34 (GND), CON1.39 (GND), J1.4, J2.2, J2.4, J4.4, SH2.DIG, U1.7 (GND), U2.8 (RES1), U2.9 (RES2), U2.10 (RES3), U2.11 (RES4), U2.12 (GND), U2.13 (GND2), U2.15 (RES5), U3.10 (10-DEMP), U3.11 (FLT-11), U3.12 (SCK-12), U3.16 (FMT-16), U3.19 (DGND-19), U4.P$2 (GND)
GPI022-OUT: J2.1, U1.11 (B3)
GPIO21: CON1.29 (GPIO5), U1.5 (A4)
GPIO21-OUT: J2.3, U1.10 (B4)
GPIO22: CON1.31 (GPIO6), U1.4 (A3)
GPIO23: CON1.33 (GPIO13), U1.3 (A2)
GPIO23-OUT: J1.1, U1.12 (B2)
GPIO25: CON1.37 (GPIO26), U1.2 (A1)
GPIO25-OUT: J1.2, U1.13 (B1)
L+: C22.1, J5.4, L1.2
L-: C23.2, J5.3, L2.2
unnamed: R5.1, U3.7 (7-OUTR)
unnamed: C8.1, U3.5 (5-VNEG)
unnamed: C9.1, U3.4 (4-CAPM)
unnamed: C9.2, U3.2 (2-CAPP)
unnamed: LED1.C, R2.2
unnamed: C21.1, U5.4 (LINN-4)
unnamed: C28.1, U5.11 (RINN-11)
unnamed: C32.1, R13.1, U5.14 (AVCC-14)
unnamed: C31.2, U5.17 (17-BSPR)
unnamed: R6.1, U3.6 (6-OUTL)
unnamed: C10.1, C11.+, U3.18 (LDOO-18)
unnamed: C25.2, U5.21 (21-BSNR)
unnamed: C19.1, U5.3 (LINP-3)
unnamed: C30.1, U5.12 (RINP-12)
unnamed: C24.2, U5.22 (22-BSNL)
unnamed: C20.2, U5.26 (26-BSPL)
unnamed: C20.1, L1.1, U5.25 (25-OUTPL)
unnamed: C24.1, L2.1, U5.23 (23-OUTNL)
unnamed: C25.1, L3.1, U5.20 (20-OUTNR)
unnamed: C31.1, L4.1, U5.18 (18-OUTPR)
unnamed: R10.1, R11.2, U5.6 (GAIN-6)
unnamed: R11.1, R12.2, U5.7 (SSCTRL-7)
unnamed: R8.1, R9.2, U5.8 (LIMTHRES-8)
unnamed: C26.1, R9.1, R12.1, U5.5 (LIMRATE-5), U5.9 (GVDD-9)
OE: CON1.38 (GPIO20), R14.2, U1.8 (OE)
PCM-CLK: CON1.12 (GPIO18), U3.13 (BCK-13)
PCM_DOUT: CON1.40 (GPIO21), U3.14 (DIN-14)
PCM_FS: CON1.35 (GPIO19), U3.15 (LRCK-15)
PWR-LED: JP1.2, R1.1
R+: C29.2, J5.1, L4.2
R-: C27.1, J5.2, L3.2
SCL: CON1.5 (GPIO3/SCL1), R4.2, U2.2 (SCL), U4.P$4 (A2)
SCL-OUT: J4.1, U4.P$1 (B2)
SDA: CON1.3 (GPIO2/SDA1), R3.2, U2.3 (SDA), U4.P$5 (A1)
SDA-OUT: J4.2, U4.P$8 (B1)

Notes on the sheet:
Accel + Gyro
GPIO
PWR amp
RPI Header
To Speakers

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
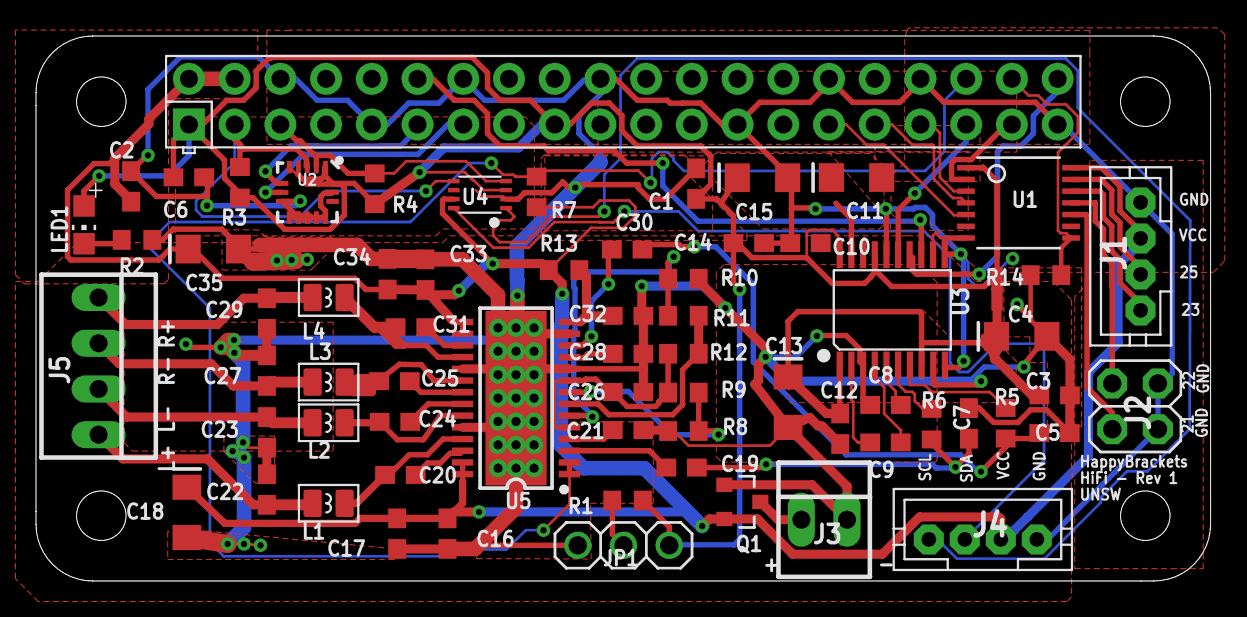
[picture p12: board PiZeroAudioI2S.brd from above]

Board: 2 copper layers, 65.3 x 30.3 mm, 69 parts (0 on the bottom side), 56 nets.
