angelofraietta/HappyBracketsPiHats/Pi-Breakout.brd

## EAGLE design Pi-Breakout.brd (2020-05-15)

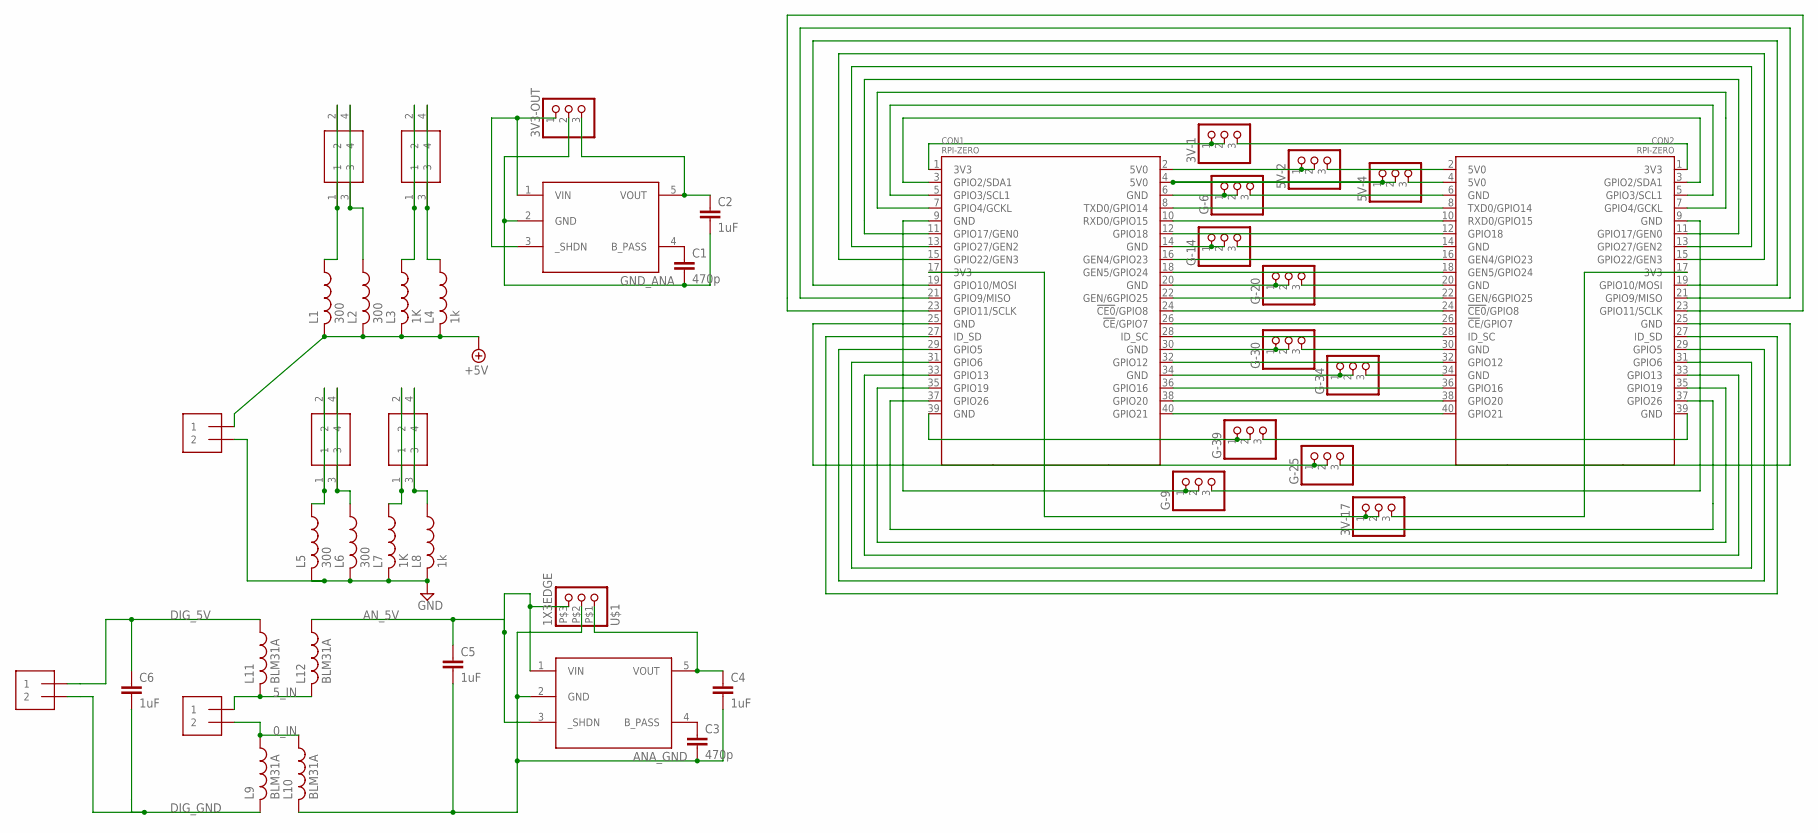
[picture p13: schematic Pi-Breakout.sch]

Parts:
3V3-OUT, 3V-1, 3V-17, 5V-2, 5V-4: PINHD-1X3; 1X03
5V1, 5V2: 2X2HEADER; 2X2
C1, C3: 470p; C0603
C2, C4, C5, C6: 1uF; C0603
CON1, CON2: RPI-ZERO; RASPBERRYPI_BASTELSTUBE_V13_RASPI_BOARD_B+_FULL
G-6, G-9, G-14, G-20, G-25, G-30, G-34, G-39: PINHD-1X3; 1X03
GND1, GND2: 2X2HEADER; 2X2
J1: 2X1-LOCKING; 22-23-2021
J2, J3: 1X2EDGE; 1X2_EDGE
L1, L2, L5, L6: 300; SML1206
L3, L7: 1K; SML1206
L4, L8: 1k; SML1206
L9, L10, L11, L12: BLM31A; SML1206
U1, U2: TC1014-3.3V; GHI-IC_SOT23-5(MICROCHIP)
U$1: 1X3EDGE; 1X3_EDGE

Connections:
0_IN: J2.P$2 (2), L9.A (1), L10.A (1)
3V3_1_B: 3V-1.1, 3V-1.2, CON1.1 (3V3)
3V3_1_PI: 3V-1.3, CON2.1 (3V3)
3V3_17_B: 3V-17.1, 3V-17.2, CON1.17 (3V3)
3V3_17_PI: 3V-17.3, CON2.17 (3V3)
5V0_B: 5V-2.1, 5V-2.2, CON1.2 (5V0)
5V0_PI: 5V-2.3, CON2.2 (5V0)
5V1_B: 5V-4.1, 5V-4.2, CON1.4 (5V0)
5V1_PI: 5V-4.3, CON2.4 (5V0)
5_IN: J2.P$1 (1), L11.C (2), L12.C (2)
+5V: J1.1, L1.C (2), L2.C (2), L3.C (2), L4.C (2)
ANA_GND: C3.2, C4.2, C5.2, L10.C (2), U2.2 (GND), U$1.P$2 (2)
AN_5V: C5.1, L12.A (1), U2.1 (VIN), U2.3 (_SHDN), U$1.P$3 (3)
DIG_5V: C6.1, J3.P$1 (1), L11.A (1)
DIG_GND: C6.2, J3.P$2 (2), L9.C (2)
GND: J1.2, L5.C (2), L6.C (2), L7.C (2), L8.C (2)
GND1: GND1.1, GND1.2, L5.A (1)
GND@7: CON1.34 (GND), G-34.1, G-34.2
GND_6_B: CON1.6 (GND), G-6.1, G-6.2
GND_6_PI: CON2.6 (GND), G-6.3
GND_9_B: CON1.9 (GND), G-9.1, G-9.2
GND_9_PI: CON2.9 (GND), G-9.3
GND_14_B: CON1.14 (GND), G-14.1, G-14.2
GND_14_PI: CON2.14 (GND), G-14.3
GND_20_B: CON1.20 (GND), G-20.1, G-20.2
GND_20_PI: CON2.20 (GND), G-20.3
GND_25_B: CON1.25 (GND), G-25.1, G-25.2
GND_25_PI: CON2.25 (GND), G-25.3
GND_30_B: CON1.30 (GND), G-30.1, G-30.2
GND_30_PI: CON2.30 (GND), G-30.3
GND_34_PI: CON2.34 (GND), G-34.3
GND_39_B: CON1.39 (GND), G-39.1, G-39.2
GND_39_PI: CON2.39 (GND), G-39.3
GND_ANA: 3V3-OUT.2, C1.2, C2.2, U1.2 (GND)
unnamed: CON1.8 (TXD0/GPIO14), CON2.8 (TXD0/GPIO14)
unnamed: CON1.10 (RXD0/GPIO15), CON2.10 (RXD0/GPIO15)
unnamed: CON1.12 (GPIO18), CON2.12 (GPIO18)
unnamed: CON1.16 (GEN4/GPIO23), CON2.16 (GEN4/GPIO23)
unnamed: CON1.18 (GEN5/GPIO24), CON2.18 (GEN5/GPIO24)
unnamed: CON1.22 (GEN/6GPIO25), CON2.22 (GEN/6GPIO25)
unnamed: CON1.24 (!CE0!/GPIO8), CON2.24 (!CE0!/GPIO8)
unnamed: CON1.26 (!CE!/GPIO7), CON2.26 (!CE!/GPIO7)
unnamed: CON1.28 (ID_SC), CON2.28 (ID_SC)
unnamed: CON1.32 (GPIO12), CON2.32 (GPIO12)
unnamed: CON1.36 (GPIO16), CON2.36 (GPIO16)
unnamed: CON1.38 (GPIO20), CON2.38 (GPIO20)
unnamed: CON1.40 (GPIO21), CON2.40 (GPIO21)
unnamed: CON1.3 (GPIO2/SDA1), CON2.3 (GPIO2/SDA1)
unnamed: CON1.5 (GPIO3/SCL1), CON2.5 (GPIO3/SCL1)
unnamed: CON1.7 (GPIO4/GCKL), CON2.7 (GPIO4/GCKL)
unnamed: CON1.11 (GPIO17/GEN0), CON2.11 (GPIO17/GEN0)
unnamed: CON1.13 (GPIO27/GEN2), CON2.13 (GPIO27/GEN2)
unnamed: CON1.15 (GPIO22/GEN3), CON2.15 (GPIO22/GEN3)
unnamed: CON1.19 (GPIO10/MOSI), CON2.19 (GPIO10/MOSI)
unnamed: CON1.21 (GPIO9/MISO), CON2.21 (GPIO9/MISO)
unnamed: CON1.23 (GPIO11/SCLK), CON2.23 (GPIO11/SCLK)
unnamed: CON1.37 (GPIO26), CON2.37 (GPIO26)
unnamed: CON1.35 (GPIO19), CON2.35 (GPIO19)
unnamed: CON1.31 (GPIO6), CON2.31 (GPIO6)
unnamed: CON1.33 (GPIO13), CON2.33 (GPIO13)
unnamed: CON1.29 (GPIO5), CON2.29 (GPIO5)
unnamed: CON1.27 (ID_SD), CON2.27 (ID_SD)
unnamed: GND1.3, GND1.4, L6.A (1)
unnamed: GND2.1, GND2.2, L7.A (1)
unnamed: GND2.3, GND2.4, L8.A (1)
unnamed: 5V1.1, 5V1.2, L1.A (1)
unnamed: 5V1.3, 5V1.4, L2.A (1)
unnamed: 5V2.1, 5V2.2, L3.A (1)
unnamed: 5V2.3, 5V2.4, L4.A (1)
unnamed: 3V3-OUT.1, U1.1 (VIN), U1.3 (_SHDN)
unnamed: C1.1, U1.4 (B_PASS)
unnamed: 3V3-OUT.3, C2.1, U1.5 (VOUT)
unnamed: C4.1, U2.5 (VOUT), U$1.P$1 (1)
unnamed: C3.1, U2.4 (B_PASS)

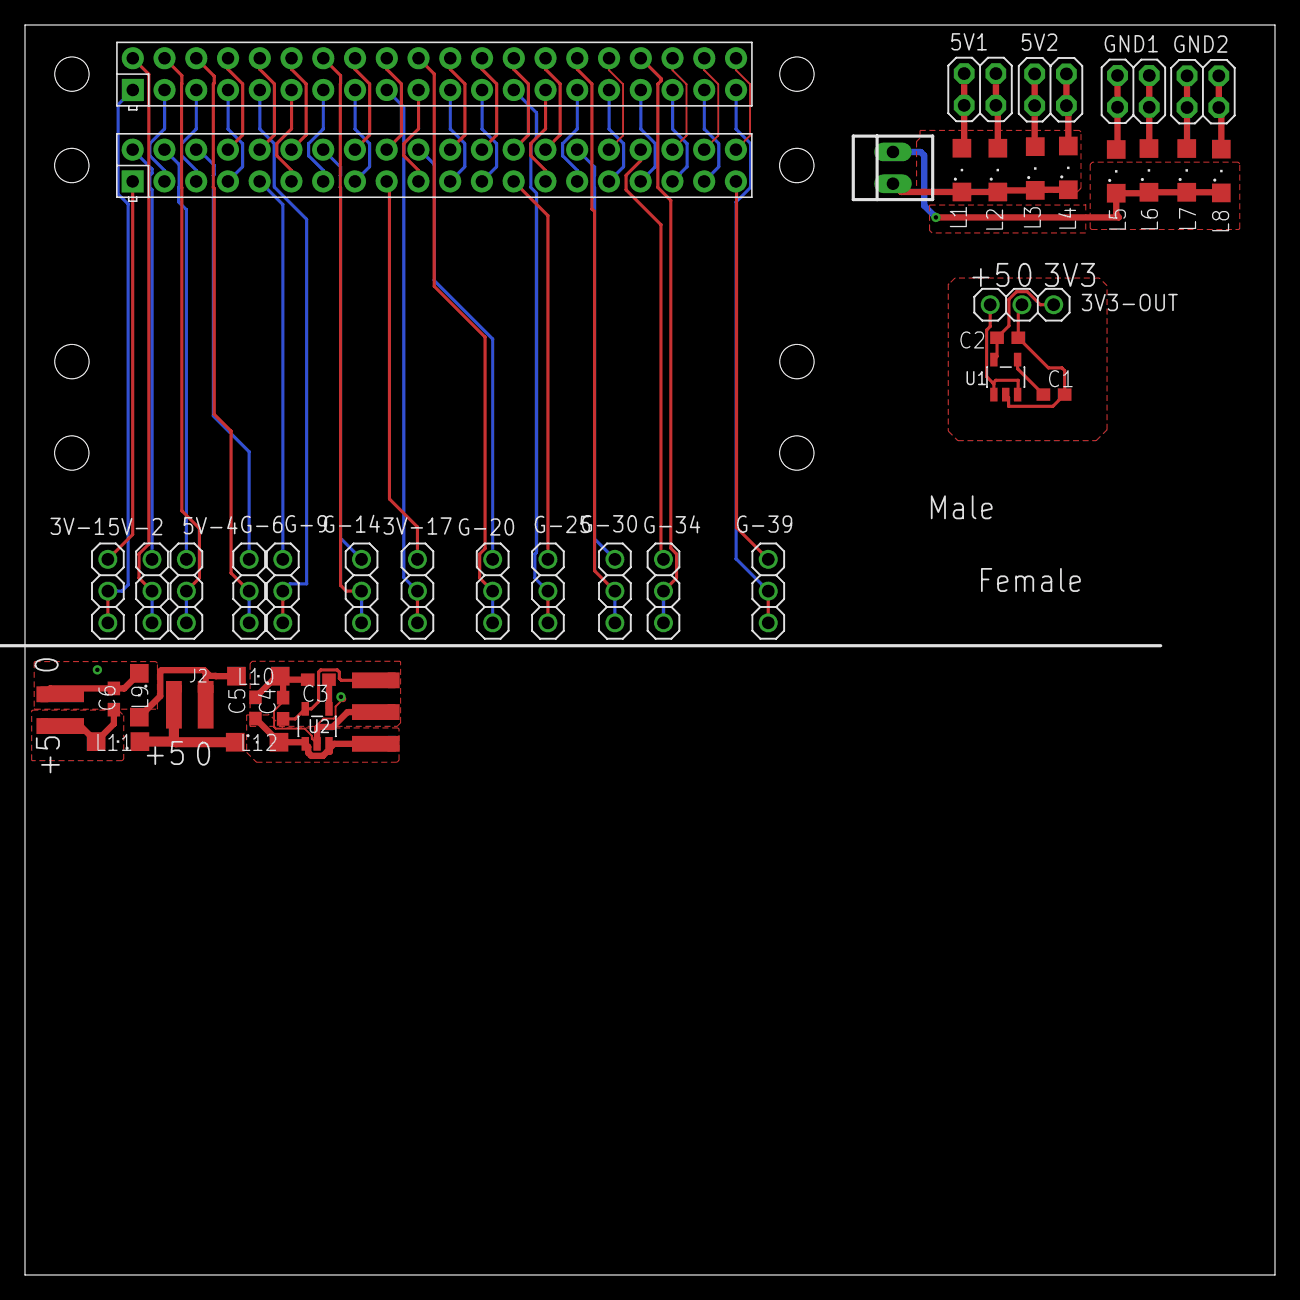
[picture p14: board Pi-Breakout.brd from above]

Board: 2 copper layers, 100.0 x 100.0 mm, 43 parts (0 on the bottom side), 74 nets.
