angelofraietta/HappyBracketsPiHats/(commit log)

2018-09-11 added compondents
    [PiZeroAudio.sch]
2018-09-12 Added Board
    [PiZeroAudio.brd, PiZeroAudio.sch]
2018-09-21 Added I2C and Amplifier
    [PiZeroAudio.brd, PiZeroAudioI2S.sch]
2018-09-24 Renumbered Pins Placed components for first board
    [PiZeroAudio.brd, PiZeroAudio.sch, PiZeroAudioI2S.sch]
2018-09-24 Pre-resync board and schematic There is board inconsitency
    [PiZeroAudio.brd, PiZeroAudio.sch]
2018-09-24 Consistency put back Removed GND pour from top
    [PiZeroAudio.brd, PiZeroAudio.sch]
2018-09-25 Applied star Power
    [PiZeroAudio.brd, PiZeroAudio.sch]
2018-09-26 Changed Ferrite Beads
    [PiZeroAudio.brd, PiZeroAudio.sch]
2018-09-26 Routed all but power
    [PiZeroAudio.brd, PiZeroAudio.sch]
2018-09-26 Added LED
    [PiZeroAudio.brd, PiZeroAudio.sch]
2018-09-27 Pre- grove connector
    [PiZeroAudio.brd, PiZeroAudio.sch, PiZeroAudioI2S.sch]
2018-09-27 Rout complete and rats nest. Need to complete pour
    [PiZeroAudio.brd]
2018-09-27 Completed Ratsnets
    [PiZeroAudio.brd]
2018-09-27 Changed Polygons so we had maximum pour
    [PiZeroAudio.brd]
2018-09-27 Added GPIO Text
    [PiZeroAudio.brd]
2018-09-27 Renumbered parts and aligned text
    [PiZeroAudio.brd, PiZeroAudio.sch]
2018-09-27 Added Title Block
    [PiZeroAudio.brd]
2018-09-28 Added I2Sboard
    [PiZeroAudioI2S.brd, PiZeroAudioI2S.sch]
2018-09-28 Performed layout
    [PiZeroAudioI2S.brd, PiZeroAudioI2S.sch]
2018-10-01 added i2C
    [PiZeroAudio.brd, PiZeroAudio.sch]
2018-10-01 added LED pin displays
    [PiZeroAudio.brd]
2018-10-02 Changed capacitor footprints
    [PiZeroAudio.brd, PiZeroAudio.sch, PiZeroAudioI2S.brd, PiZeroAudioI2S.sch]
2018-10-02 Completed route
    [PiZeroAudioI2S.brd]
2018-10-02 added AGND polygon
    [PiZeroAudioI2S.brd]
2018-10-02 added additional polygon
    [PiZeroAudioI2S.brd]
2018-10-02 Added Titleblock
    [PiZeroAudioI2S.brd]
2018-10-02 changed component values so they are consistent
    [PiZeroAudioI2S.brd, PiZeroAudioI2S.sch]
2018-10-02 Added Bill of Materials
    [PiZeroAudio.csv, PiZeroAudioI2S.csv]
2018-10-03 Added GerberFiles
2018-10-03 BOM as Text
2018-10-03 Added BOM
2018-10-06 Changed Capacitor sizes for tant caps
    [PiZeroAudio.brd, PiZeroAudio.sch, PiZeroAudioI2S.brd, PiZeroAudioI2S.sch]
2018-10-06 Updated BOM
2018-10-07 Added gnd to SCK pin
    [PiZeroAudioI2S.brd, PiZeroAudioI2S.sch]
2018-10-07 Corrected Speaker pin text
    [PiZeroAudio.brd, PiZeroAudioI2S.brd]
2018-10-07 Added Pam 8403
    [PiZeroAudioI2SPam8403.brd, PiZeroAudioI2SPam8403.sch]
2018-10-07 Fit Charger Parts
    [PiZeroAudioI2SPam8403.brd, PiZeroAudioI2SPam8403.sch]
2018-10-08 Routed to Audio
    [PiZeroAudioI2SPam8403.brd, PiZeroAudioI2SPam8403.sch]
2018-10-08 Routed with ratsnest
    [PiZeroAudioI2SPam8403.brd, PiZeroAudioI2SPam8403.sch]
2018-10-08 Changed Footprints for consistency
    [PiZeroAudioI2SPam8403.brd, PiZeroAudioI2SPam8403.sch]
2018-10-08 Updated Capacitor footprint
    [PiZeroAudioI2SPam8403.brd, PiZeroAudioI2SPam8403.sch]
2018-10-08 Changed Current Resistor to 100K
    [PiZeroAudioI2SPam8403.brd, PiZeroAudioI2SPam8403.sch]
2018-10-08 Made Values consistent with Upper case K
    [PiZeroAudioI2SPam8403.brd, PiZeroAudioI2SPam8403.sch]
2018-10-09 Changed the name of RPI Header
    [PiZeroAudio.brd, PiZeroAudio.sch, PiZeroAudioI2S.brd, PiZeroAudioI2S.csv, PiZeroAudioI2S.sch, PiZeroAudioI2SPam8403.brd, PiZeroAudioI2SPam8403.sch]
2018-10-09 Removed csv
    [PiZeroAudio.csv]
2018-10-09 Added Slikscreen
    [PiZeroAudioI2S.brd, PiZeroAudioI2SPam8403.brd]
2018-10-09 Added I2C to silkscreen
2018-10-09 updated fomts
    [PiZeroAudio.brd, PiZeroAudioI2S.brd, PiZeroAudioI2SPam8403.brd]
2018-10-30 Swapped position of Mosfet Capacitively coupled Audio Set OE of I2C translator to GND Set Mute so it floats to +5
    [PiZeroAudio.brd, PiZeroAudio.sch, PiZeroAudioI2S.brd, PiZeroAudioI2S.sch, PiZeroAudioI2SPam8403.brd, PiZeroAudioI2SPam8403.sch]
2018-10-30 Adjusted Layout
    [PiZeroAudioI2S.brd]
2018-10-31 Build Revision 1
    [PiZeroAudioI2S.brd, PiZeroAudioI2S.sch]
2018-10-31 Added R14 10K resistance to translator
    [PiZeroAudioI2S-01-Nov-18.xlsx, PiZeroAudioI2S.brd, PiZeroAudioI2S.sch]
2018-11-01 Updated BOM and zip
    [PiZeroAudioI2S-31-Oct-18.xlsx]
2018-12-28 Added Breakout
    [Pi-Breakout.brd, Pi-Breakout.sch, PiZeroAudioI2S-01-Nov-18.xlsx, PiZeroAudioI2S.brd, PiZeroAudioI2S.sch]
2018-12-29 Added Second CIRCUIT
    [Pi-Breakout.brd, Pi-Breakout.sch]
2020-03-31 Update for Move account
    [PiZeroAudioI2S.brd, PiZeroAudioI2S.sch]
2020-05-15 Added PiZeroHifi
    [PiZeroHifi.brd, PiZeroHifi.sch]
2020-05-15 CHanged to Use Angelo version of HappyBrackets library
    [Pi-Breakout.brd, Pi-Breakout.sch, PiZeroAudio.brd, PiZeroAudio.sch, PiZeroAudioI2S.brd, PiZeroAudioI2S.sch, PiZeroAudioI2SPam8403.brd, PiZeroAudioI2SPam8403.sch]
2020-07-31 Added Hifi Board
    [PiZeroHifi.brd]
2020-08-05 Route HifiBoard
    [PiZeroHifi.brd, PiZeroHifi.sch]
2020-08-05 Change position of GPIO
    [PiZeroHifi.brd, PiZeroHifi.sch]
2020-08-05 Revert "Added Hifi Board"
    This reverts commit 465897fff771744b6bd4fb0467af0f24cf217bbb.
    [PiZeroHifi.brd]
